alanssitis/smart-air-hockey-table/web/README.md

# Better Website

Just a better site in every way.

All settings are set properly for copy-and-paste into the `/web` directory
of the shay drive. All that needs to be done is to build it.

## Installing `npm`

I use `nvm` to manage node versions. My local machine is running `v18.16.0` as
of Sep 5, 2023.

## Building the site

First, install all dependencies with

```
npm install .
```

Than, build the project with

```
npm run build
```

This will create all the requisites in `/dist`. The contents of `/dist` can
be copied to the shay `/web` directory.
