alanssitis/smart-air-hockey-table/web/src/pages/media.md

---
layout: ../layouts/MDLayout.astro
title: ECE 477 Team 5 Media
---

# Media

## Project Photos

### Master PCB

_Master PCB Rev. B Render_

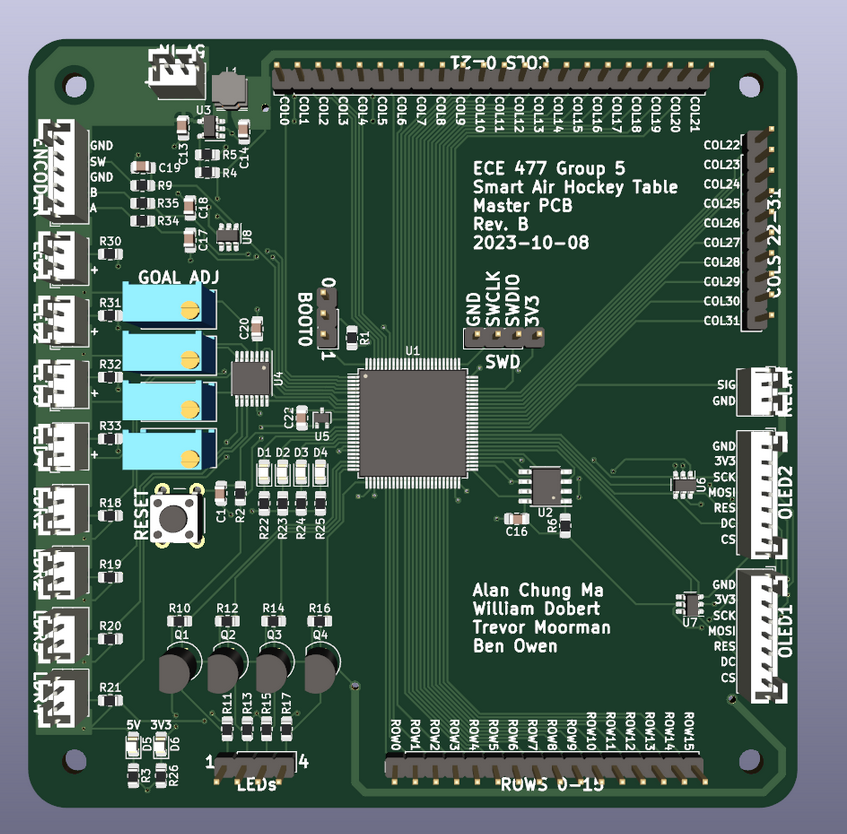
[picture p2: web/public/media/master-pcb-render.png]


_Master PCB Rev. A (assembled)_

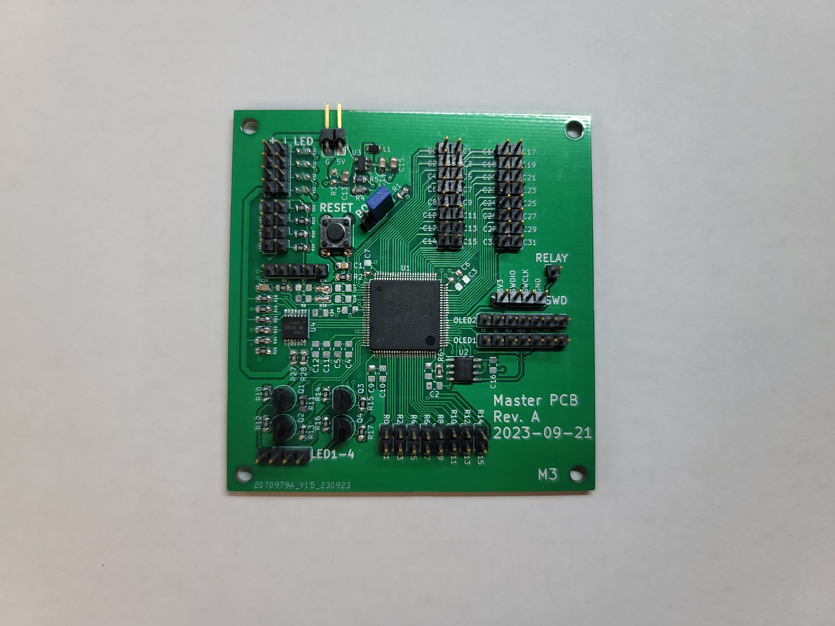
[picture p3: web/public/media/master-pcb-reva.jpg]


### Sensor PCB

_Sensor PCB (assembled)_

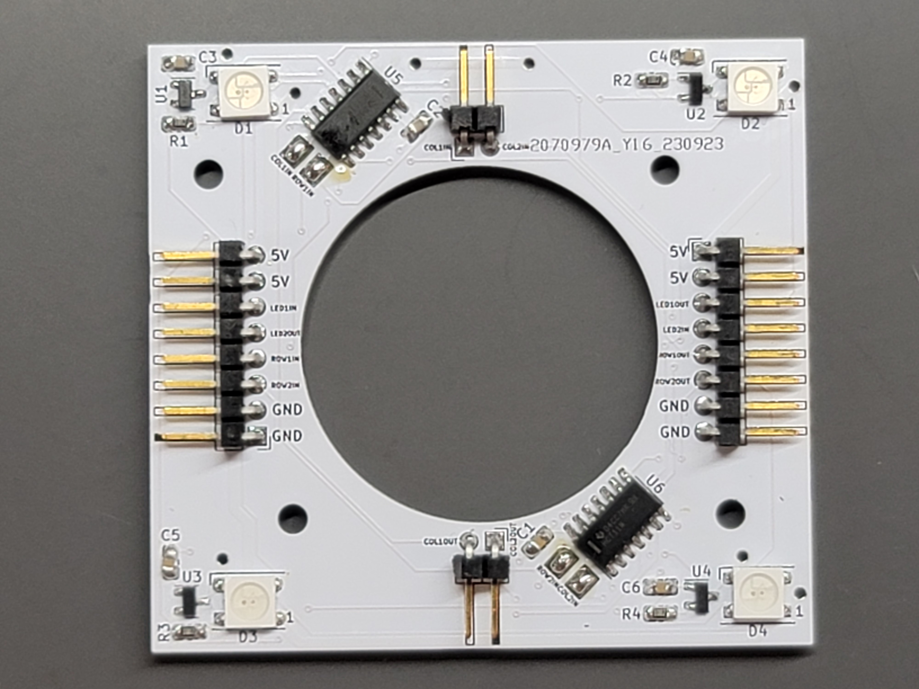
[picture p4: web/public/media/sensor-pcb.jpg]


_Sensor PCB testing_

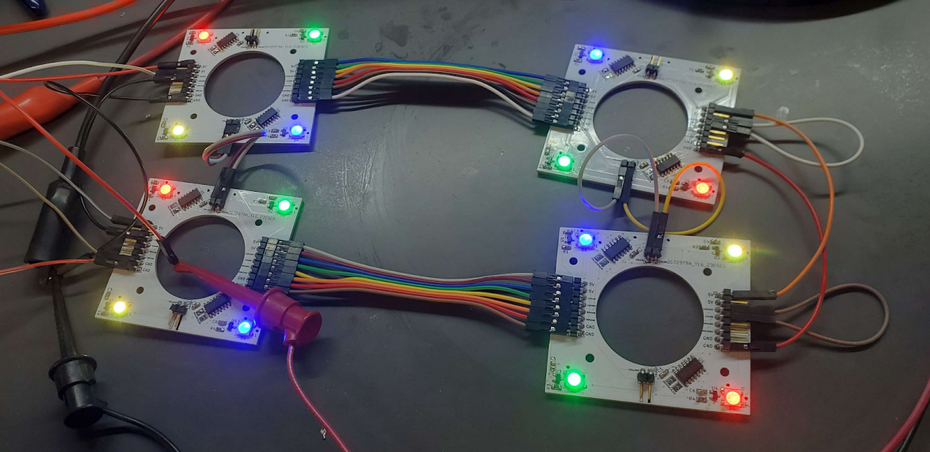
[picture p5: web/public/media/sensor-pcb-lights.png]


## Project Videos

_Sensor PCB testing_

<video controls muted>
  <source src="/team/ben/week6-outlet-relay-test.mp4" type="video/mp4">
</video>
