alanssitis/smart-air-hockey-table/web/public/team/ben/ben-brainstorming-20230901.pdf

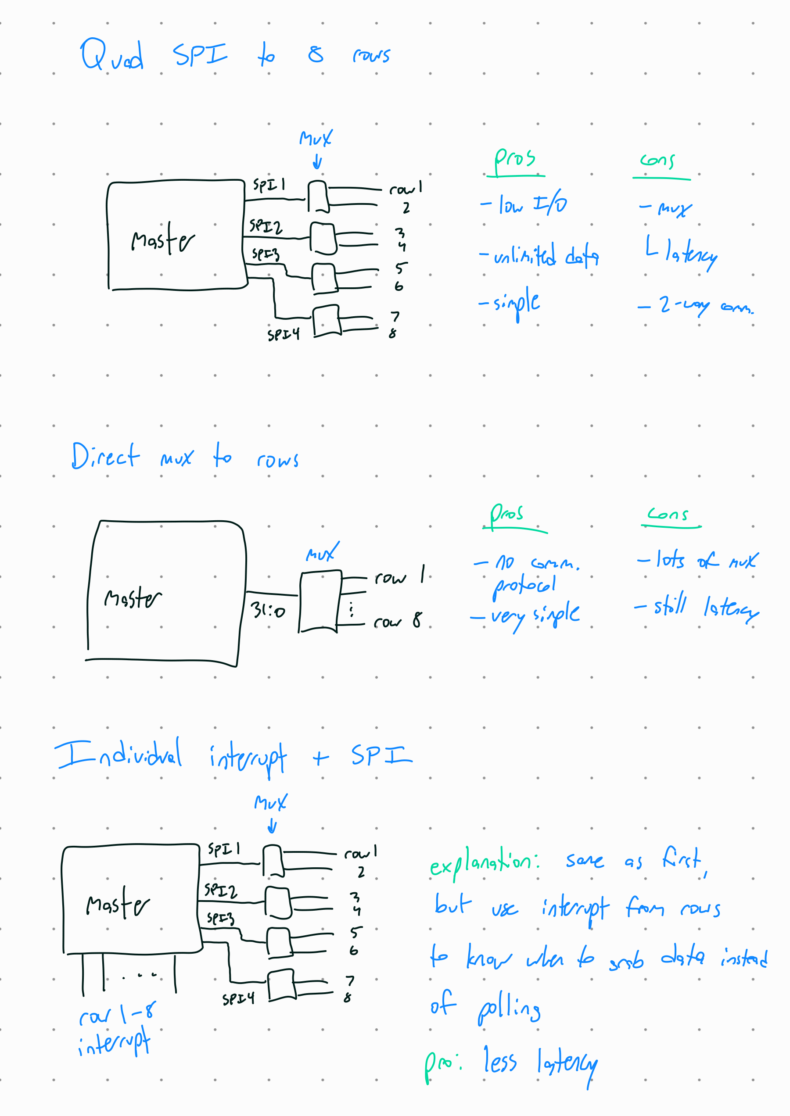
[picture p179: page 1]
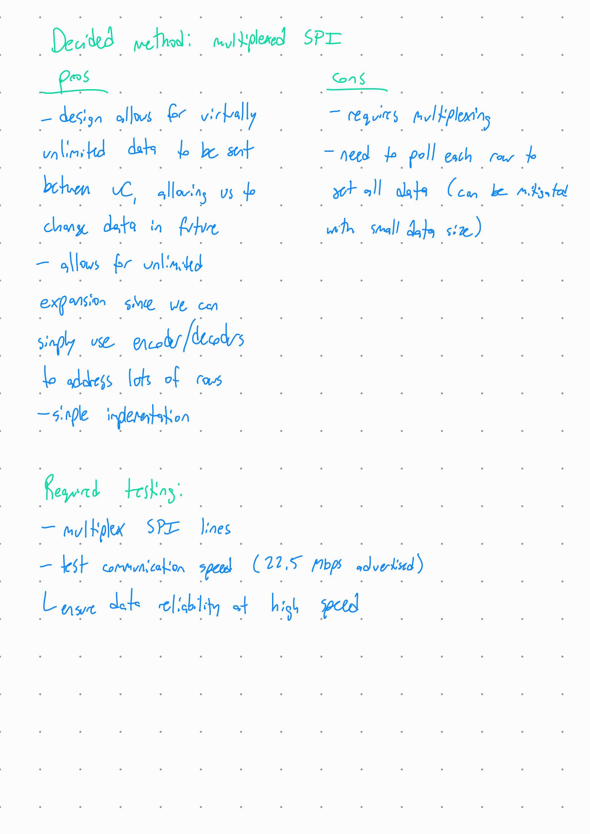
[picture p180: page 2]
