alanssitis/smart-air-hockey-table/web/public/documents/A7 - Bill of Materials.xlsx

ECE477 Bill of Materials v1.0
Year: 2023 |  | Semester: Fall |  |  | Project Name: Smart Air Hockey Table
Authors: Alan Chung Ma, Benjamin Owen, Trevor Moorman, William Dobert
Created: 9/19/2023
Last Modified: 9/23/2023
Main Board |  |  |  |  |  |  |  | Qty: | 1
Description | ID | Qty | Value | Package | Manufacturer | Mfg. Part # | Supplier | Supplier Part #
Microcontroller | STM32U585VIT6 | 1 | - | LQFP100 | STMicroelectronics | STM32U585VIT6 | DigiKey | 497-STM32U585VIT6-ND
OLED Display | SSD1309 | 2 | - | - | Teyleten Robot | SSD1309 | Amazon | ‎B09LND6QJ1
Quad Comparator | LM339 | 1 | - | TSSOP14 | Texas Instruments | LM339PWRG3 | DigiKey | 296-27782-2-ND
Button Rotary Encoder | PEC09-2120F-S0012 | 1 | - | - | Bourns | PEC09-2120F-S0012 | DigiKey | PEC09-2120F-S0012-ND
EEPROM | M95P32-I | 1 | - | SO-8 | STMicroelectronics | M95P32-IXMNT/E | DigiKey | 497-M95P32-IXMNT/ETR-ND
Buck Converter | TLV62568 | 1 | - | - | Texas Instruments | TLV62568DBVR | DigiKey | 296-47359-2-ND
Printed Circuit Board | PCB | 1 | - | - | JLCPCB | - | JLCPCB | -
LED | - | 4 | - | - | - | - | ECE Shop | -
Photoresistor | - | 4 | - | - | - | - | ECE Shop | -
Inductor | DFE21CCN2R2 | 1 | 2.2uH | 0805 | Murata | DFE21CCN2R2MELL | DigiKey | 490-DFE21CCN2R2MELLTR-ND
Resistor | - | 1 | 680K | 0805 | - | - | ECE Shop | -
Resistor | - | 1 | 150K | 0805 | - | - | ECE Shop | -
Pin Headers | 9-146280-0-08 | 12 | - | - | TE Connectivity | 9-146280-0-08 | DigiKey | A32701-08-ND
Daughterboard |  |  |  |  |  |  |  | Qty: | 128
Description | ID | Qty | Value | Package | Manufacturer | Mfg. Part # | Supplier | Supplier Part #
Digital Hall Effect Sensors | DRV5033FA | 4 | - | SOT-23 | Texas Instruments | DRV5033FAQDBZR | DigiKey | 296-44589-2-ND
Triple 3-Way AND Gates | CD74HCT11 | 1 | - | SOIC-14 | Texas Instruments | CD74HCT11M96 | DigiKey | 296-9249-2-ND
RGB LEDs | WS2812B | 4 | - | 5050 | Worldsemi | WS2812B | AliExpress | 3256802466699315
Printed Circuit Board | PCB | 1 | - | - | JLCPCB | - | JLCPCB | -
Pin Headers | 9-103325-0-08 | 3 | - | - | TE Connectivity | 9-103325-0-08 | DigiKey | A32702-08-ND
Dupont Wires | ED-DP_L10_F-F_120pcs | 10 | - | - | EDGELEC | - | Amazon | B07GD312VG
Air Hockey Table |  |  |  |  |  |  |  | Qty: | 1
Description | ID | Qty | Value | Package | Manufacturer | Mfg. Part # | Supplier | Supplier Part #
Centrifugal Blower | 1TDP7 | 1 | 115 Volt, 146 CFM | - | DAYTON | 1TDP7 | Amazon | B00G03XS64
BC Sanded Pine Plywood | - | 1 | 23/32 in. x 4 ft. x 8 ft. | - | Plytanium | 201428 | Home Depot | 166057
MDF Panel | - | 1 | 3/4 in. x 4 ft. x 8 ft. | - | Home Depot | D11612490970000 | Home Depot | 201566
Thick Acrylic Non-Glare, Matte P95 Sheet | - | 1 | 36 in. x 72 in. x 0.125 in. | - | Falken Design | ACRYLIC-P95-1-8/3672 | Home Depot | 1004114887
Wood Panels | - | 8 | - | - | N/A | - | BIDC Back Room | -
AC/DC Transformer Switching Power Supply | YC5V70ATUS | 1 | 5V20A | - | Aclorol | YC5V70ATUS | Amazon | B09J2BFT93
