alanssitis/smart-air-hockey-table/hardware/CAD/Goal_Chute/Goal_Chute.stl

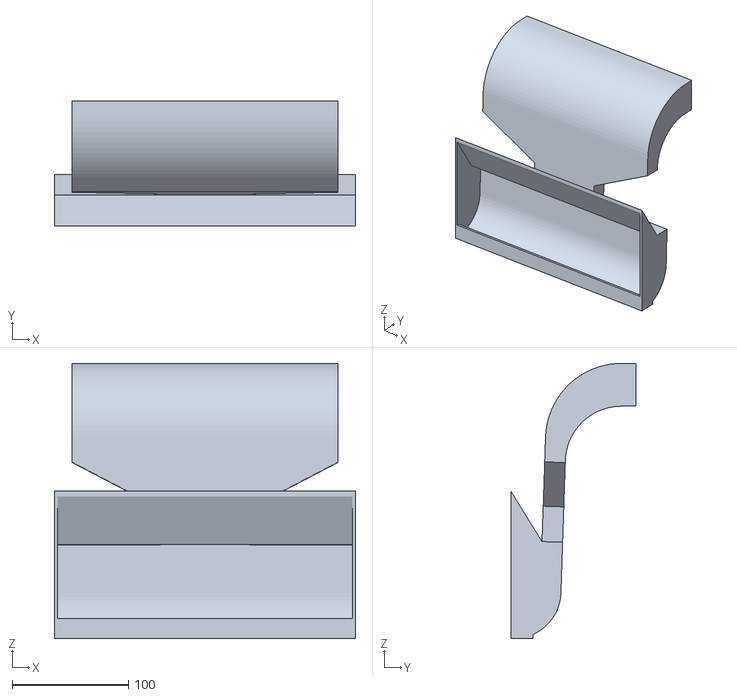
[picture p182: CAD file, 2023-12-10]
hardware/CAD/Goal_Chute/Goal_Chute.stl
259.1 x 107.9 x 236.9
