alanssitis/smart-air-hockey-table/hardware/CAD/Knob/Knob.stl

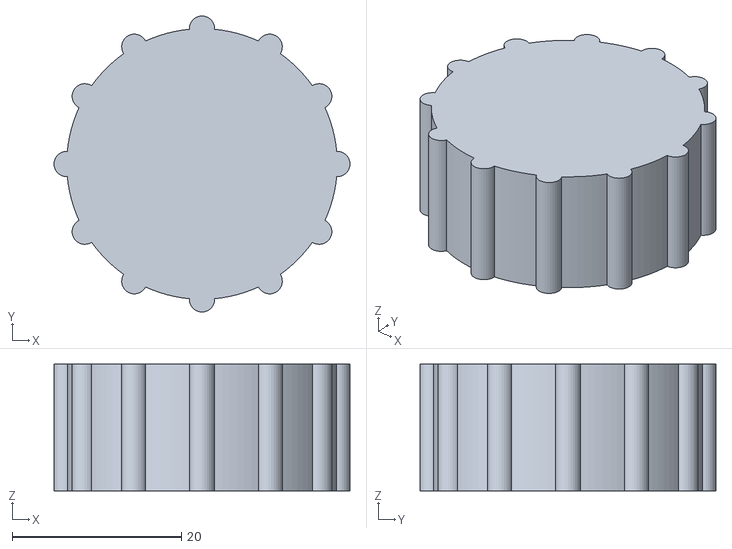
[picture p183: CAD file, 2023-12-10]
hardware/CAD/Knob/Knob.stl
35.0 x 35.0 x 15.0
