alanssitis/smart-air-hockey-table/hardware/CAD/PCB_Mounting/PCB_Mounting.stl

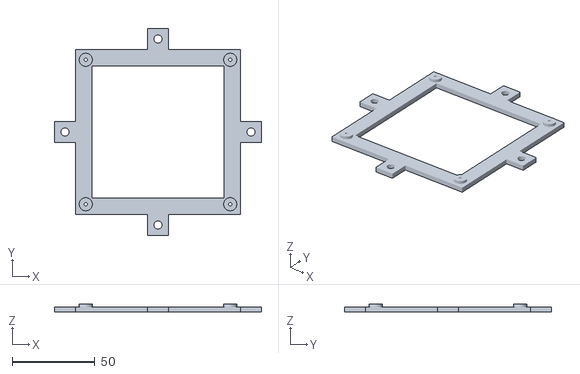
[picture p184: CAD file, 2023-12-10]
hardware/CAD/PCB_Mounting/PCB_Mounting.stl
125.4 x 125.4 x 5.00
