alanssitis/smart-air-hockey-table/hardware/CAD/PSU_Mounting/PSU_Mounting.stl

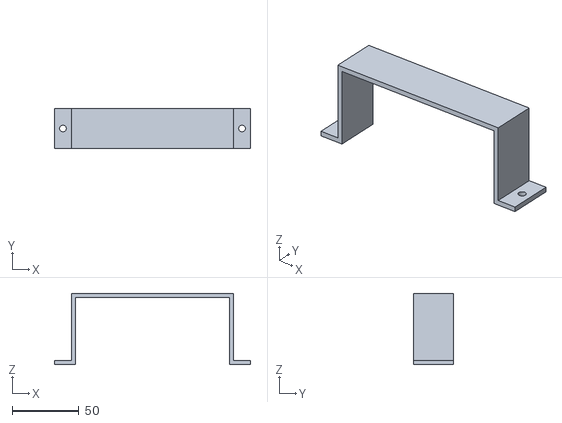
[picture p185: CAD file, 2023-12-10]
hardware/CAD/PSU_Mounting/PSU_Mounting.stl
146.8 x 30.0 x 53.2
