alanssitis/smart-air-hockey-table/hardware/CAD/Puck/Puck-SingleMagnet-Body-Medium.stl

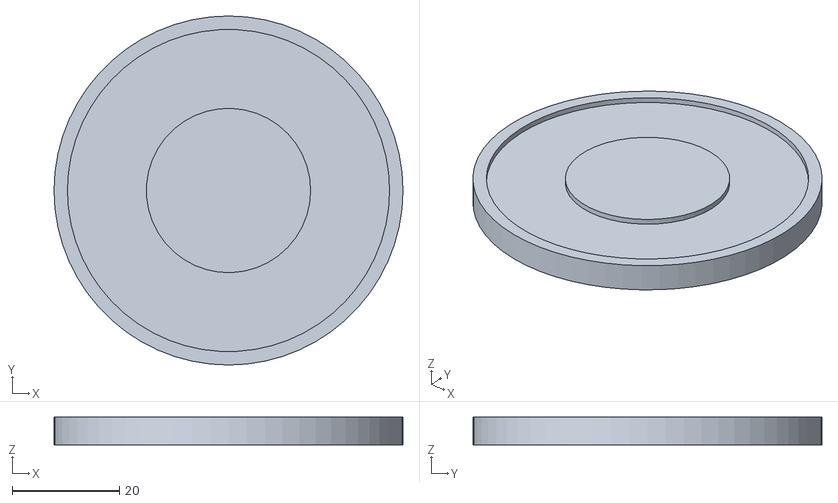
[picture p186: CAD file, 2023-12-10]
hardware/CAD/Puck/Puck-SingleMagnet-Body-Medium.stl
65.0 x 65.0 x 5.20
