alanssitis/smart-air-hockey-table/hardware/CAD/Pusher/Pusher.stl

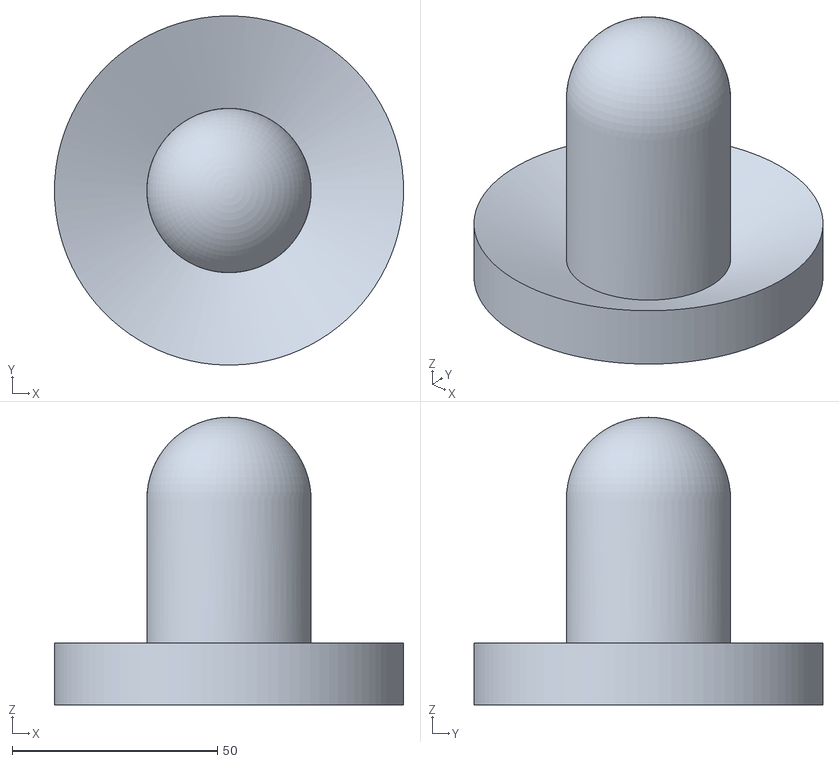
[picture p187: CAD file, 2023-12-10]
hardware/CAD/Pusher/Pusher.stl
85.0 x 85.0 x 70.0
