alanssitis/smart-air-hockey-table/hardware/CAD/Spacers/Spacers-Body.stl

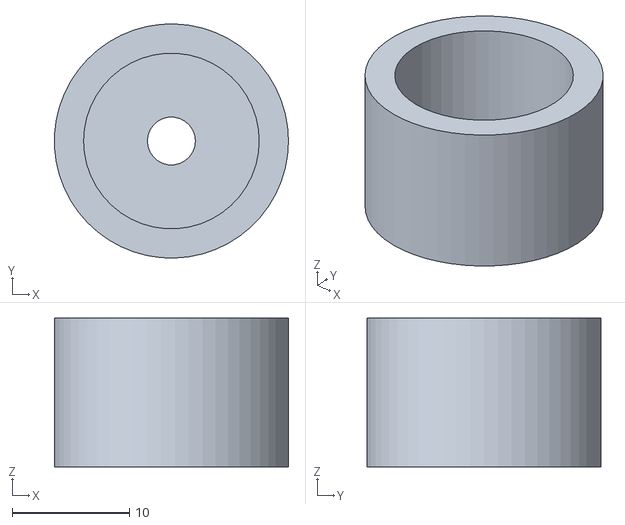
[picture p188: CAD file, 2023-12-02]
hardware/CAD/Spacers/Spacers-Body.stl
20.0 x 20.0 x 12.7
