alanssitis/smart-air-hockey-table/hardware/CAD/Table/Built+to+size.stl

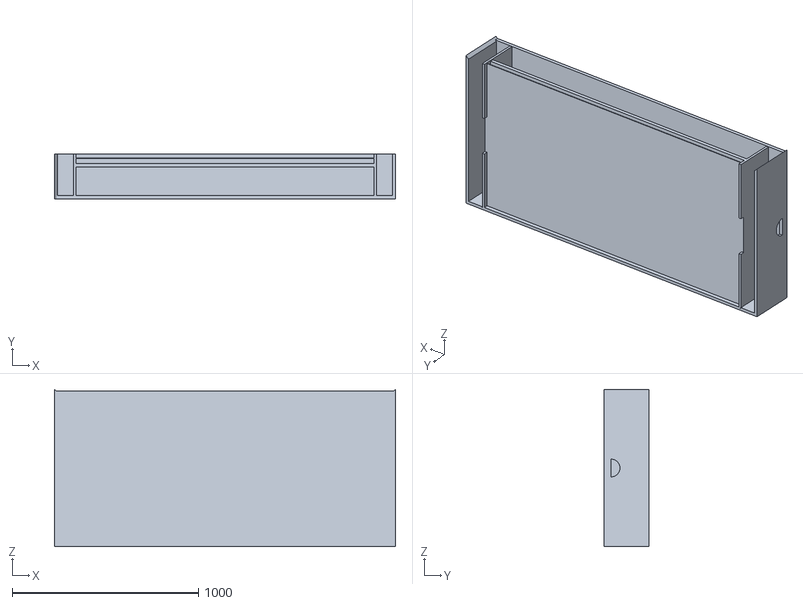
[picture p189: CAD file, 2023-10-10]
hardware/CAD/Table/Built+to+size.stl
1828.8 x 241.3 x 844.5
