alanssitis/smart-air-hockey-table/hardware/CAD/Puck/Puck-SingleMagnet-Body.stl

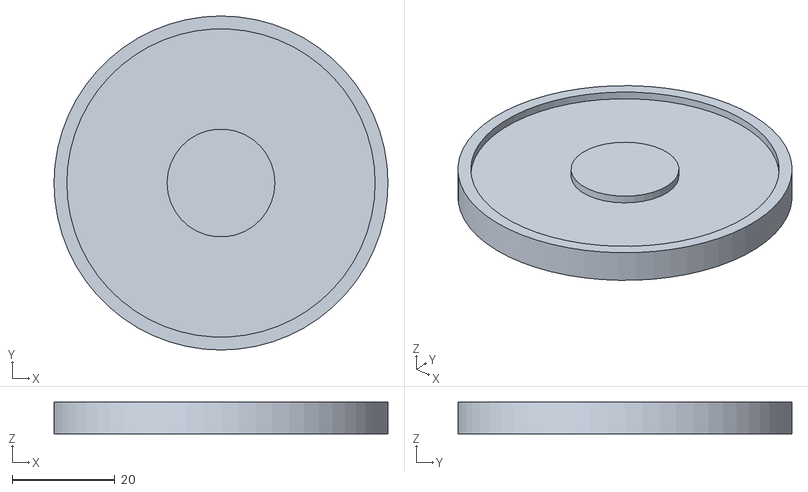
[picture p190: CAD file, 2023-12-03]
hardware/CAD/Puck/Puck-SingleMagnet-Body.stl
65.0 x 65.0 x 6.20
