alanssitis/smart-air-hockey-table/(list of files, cad)

Other CAD files:
hardware/CAD/Puck/Puck-SingleMagnet.FCStd
hardware/CAD/Spacers/Spacers.FCStd
hardware/CAD/Goal_Chute/Goal_Chute.f3d
hardware/CAD/Knob/Knob.f3d
hardware/CAD/PCB_Mounting/PCB_Mounting.f3d
hardware/CAD/PSU_Mounting/PSU_Mounting.f3d
hardware/CAD/Pusher/Pusher.f3d
hardware/CAD/Table/Built+to+size.f3d
