alanssitis/smart-air-hockey-table/(threads)

Thread 46 (2023-09-21):

Driver: OLED Displays

WDobert, 2023-09-21:
### General Specifications (SSD1309)
- 128x64 dot matrix, 1 bit depth
- 3.3V Power and Logic
- 10 MBaud Maximum SPI Interface
- 101.9 Hz default refresh rate

### Pinout
| Pin | Name | Function | Connection |
| --- | --- | --- | --- |
| **1** | *GND* | power ground | All |
| **2** | *VCC* | power positive | All |
| **3** | *SCL* | clock | Shared SPI |
| **4** | *SDA* | data | Shared SPI |
| **5** | *RES* | reset | Shared OLED |
| **6** | *DC* | data/command select | Shared OLED |
| **7** | *CS* | chip select | Individual |

### Functional Specifications
- *SCL* rising edge reads another bit *SDA* MSB first
  - DC determines whether the read byte is data or a command
- *RES* pulled low sets the following:
  - Display off
  - 128x64 display mode
  - `SEG0` and `COM0` mapped to address 0
  - Serial data shift register cleared
  - Display start line set to address 0
  - Column address counter set to 0
  - Normal scan direction of `COM` outputs
  - Contrast control register set to **0x7F**
  - Normal display mode (equal to **0xA4** command)
- Memory Layout is 8 pages-> 128 columns -> 8 bits

See power on sequence on **page 26**.
See frame frequency selection on **page 22**.
See command descriptions on **page 36**.

Closed 2023-10-05.

Thread 86 (2023-10-16):

Driver: Push Button Rotary Encoder

WDobert, 2023-10-16:
- Physical Requirements
  - [Product Page](https://www.digikey.com/en/products/detail/bourns-inc/PEC09-2120F-S0012/2440258)
  - 1 GPIO input pin for push button
  - Hardware timer with support for "Encoder" mode
  - 2 input pins associated with timer
- Firmware Interface
  - `void Driver_Encoder_Tick()`
  - `uint8_t Driver_Encoder_PollButton()`
  - `int8_t Driver_Encoder_PollRotation()`
  - `void Driver_Encoder_SetActive(uint8_t active)`

Closed 2023-10-17.

Thread 93 (2023-10-18):

DMA for Display Driver

WDobert, 2023-10-18:
Currently, we have the CPU feeding individual bytes to SPI to fill regions of the display.
Instead, the CPU will write to a display buffer, and DMA will stream that to SPI to update the entire display.
Basically just make it similar to the LED driver.

Closed 2023-10-18.

Thread 94 (2023-10-18):

Driver: Blower Fan Power Relay

WDobert, 2023-10-18:
- Physical Requirements
  - [Blower Fan](https://www.amazon.com/dp/B00G03XS64)
  - [Power Relay](https://www.amazon.com/dp/B00WV7GMA2)
  - 1 GPIO output pin
- Firmware Interface
  - `void Driver_Fan_SetPowered(uint8_t powered)`

Closed 2023-10-19.

Thread 107 (2023-10-24):

Replace EXTI in `driver_encoder.c` With Software Debouncing

WDobert, 2023-10-24:
Filter in the same manner as `driver_goal.c`.

Closed 2023-10-25.

Thread 110 (2023-10-26):

Remove Most Instances of `volatile` Keyword

WDobert, 2023-10-26:
Only variables modified by interrupts with higher priority than `TIM7_Handler` need to be `volatile`.

`volatile` tells compiler that the value could change at any time, even if the current function doesn't modify it. It means the value is reloaded from RAM basically any time it is read, instead of leaving it cached in a register.

Closed 2023-10-27.

Thread 121 (2023-10-30):

Implement `Driver_LED_GetColor` Function

WDobert, 2023-10-30:
Any advanced visuals, such as "fade", require modifying previously set LED matrix colors instead of blindly overwriting.

Additional matrix state will need to be kept in RAM since reconstructing it from the data buffer would be drastically slower.

Recommend storing this state as an array of structs with 3 `uint8_t` members (r, g, b), and converting the setter/getter functions to pass it instead of `uint32_t`.

Recommend exposing `LED_MATRIX_WIDTH` and `LED_MATRIX_HEIGHT` in `driver_led.h`.

benjamin-owen, 2023-10-30:
Probably unnecessarily reducing performance, we can simply have a 2nd buffer which is added to the first one.  This ensures sequential memory accesses (and less of them).

We could also keep a list of changes to be made.  This reduces processing time and only changes what needs to be changed.

WDobert, 2023-10-30:
Closed in favor of #123

Closed 2023-10-30.

Thread 136 (2023-11-06):

Verify PCB Functionality

WDobert, 2023-11-06:
- [x] Buck Converter
- [x] Microcontroller Communication
- [x] Debug LEDs
- [x] Reset Button
- [x] Rotary Encoder
- [x] LDRs
- [x] OLEDs
- [x] LED Matrix Channels
- [x] Hall Effect Polling
- [x] Blower Fan Relay

benjamin-owen, 2023-11-06:
:nerd_face:

Closed 2023-11-07.
