alanssitis/smart-air-hockey-table/hardware/Master PCB/Master PCB.kicad_pcb

## KiCad design hardware/Master PCB/Master PCB.kicad_pcb (2023-10-10)

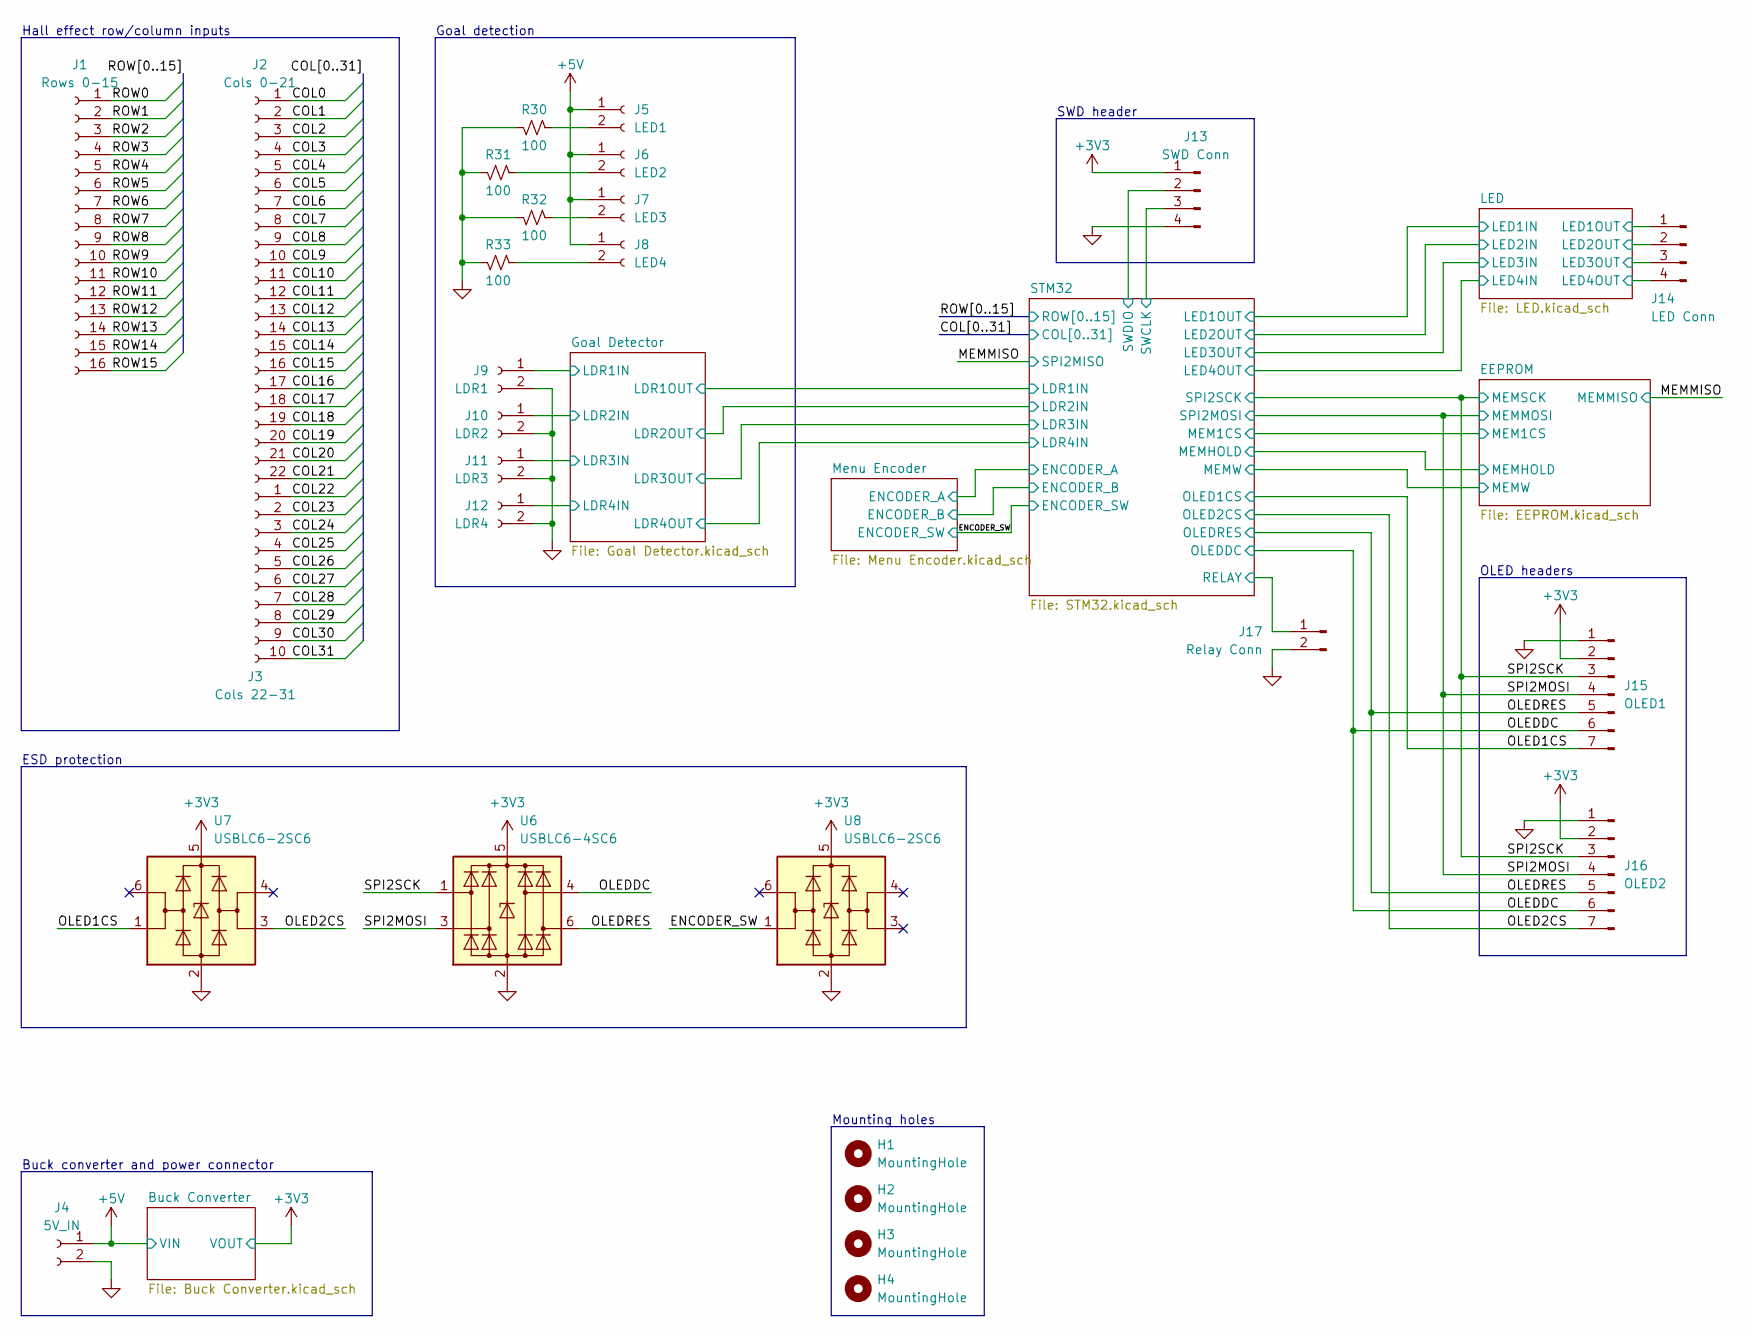
[picture p193: schematic Master PCB.kicad_sch, Smart Air Hockey Table Master PCB]

Parts:
H1, H2, H3, H4: MountingHole; MountingHole_3.2mm_M3
J1: Rows 0-15; PinHeader_1x16_P2.54mm_Vertical
J2: Cols 0-21; PinHeader_1x22_P2.54mm_Vertical
J3: Cols 22-31; PinHeader_1x10_P2.54mm_Vertical
J4: 5V_IN; JST_PH_B2B-PH-K_1x02_P2.00mm_Vertical
J5: LED1; JST_PH_B2B-PH-K_1x02_P2.00mm_Vertical
J6: LED2; JST_PH_B2B-PH-K_1x02_P2.00mm_Vertical
J7: LED3; JST_PH_B2B-PH-K_1x02_P2.00mm_Vertical
J8: LED4; JST_PH_B2B-PH-K_1x02_P2.00mm_Vertical
J9: LDR1; JST_PH_B2B-PH-K_1x02_P2.00mm_Vertical
J10: LDR2; JST_PH_B2B-PH-K_1x02_P2.00mm_Vertical
J11: LDR3; JST_PH_B2B-PH-K_1x02_P2.00mm_Vertical
J12: LDR4; JST_PH_B2B-PH-K_1x02_P2.00mm_Vertical
J13: SWD Conn; PinHeader_1x04_P2.54mm_Vertical
J14: LED Conn; PinHeader_1x04_P2.54mm_Vertical
J15: OLED1; JST_PH_B7B-PH-K_1x07_P2.00mm_Vertical
J16: OLED2; JST_PH_B7B-PH-K_1x07_P2.00mm_Vertical
J17: Relay Conn; JST_PH_B2B-PH-K_1x02_P2.00mm_Vertical
R30, R31, R32, R33: 100; R_0805_2012Metric_Pad1.20x1.40mm_HandSolder
U6: USBLC6-4SC6; SOT-23-6
U7, U8: USBLC6-2SC6; SOT-23-6

Connections:
/COL0: J2.1; also elsewhere on the board
/COL1: J2.2; also elsewhere on the board
/COL2: J2.3; also elsewhere on the board
/COL3: J2.4; also elsewhere on the board
/COL4: J2.5; also elsewhere on the board
/COL5: J2.6; also elsewhere on the board
/COL6: J2.7; also elsewhere on the board
/COL7: J2.8; also elsewhere on the board
/COL8: J2.9; also elsewhere on the board
/COL9: J2.10; also elsewhere on the board
/COL10: J2.11; also elsewhere on the board
/COL11: J2.12; also elsewhere on the board
/COL12: J2.13; also elsewhere on the board
/COL13: J2.14; also elsewhere on the board
/COL14: J2.15; also elsewhere on the board
/COL15: J2.16; also elsewhere on the board
/COL16: J2.17; also elsewhere on the board
/COL17: J2.18; also elsewhere on the board
/COL18: J2.19; also elsewhere on the board
/COL19: J2.20; also elsewhere on the board
/COL20: J2.21; also elsewhere on the board
/COL21: J2.22; also elsewhere on the board
/COL22: J3.1; also elsewhere on the board
/COL23: J3.2; also elsewhere on the board
/COL24: J3.3; also elsewhere on the board
/COL25: J3.4; also elsewhere on the board
/COL26: J3.5; also elsewhere on the board
/COL27: J3.6; also elsewhere on the board
/COL28: J3.7; also elsewhere on the board
/COL29: J3.8; also elsewhere on the board
/COL30: J3.9; also elsewhere on the board
/COL31: J3.10; also elsewhere on the board
/ENCODER_SW: U8.1 (I/O1); also elsewhere on the board
/Goal Detector/LDR1IN: J9.1; also elsewhere on the board
/Goal Detector/LDR2IN: J10.1; also elsewhere on the board
/Goal Detector/LDR3IN: J11.1; also elsewhere on the board
/Goal Detector/LDR4IN: J12.1; also elsewhere on the board
/LED/LED1OUT: J14.1; also elsewhere on the board
/LED/LED2OUT: J14.2; also elsewhere on the board
/LED/LED3OUT: J14.3; also elsewhere on the board
/LED/LED4OUT: J14.4; also elsewhere on the board
/OLED1CS: J15.7, U7.1 (I/O1); also elsewhere on the board
/OLED2CS: J16.7, U7.3 (I/O2); also elsewhere on the board
/OLEDDC: J15.6, J16.6, U6.4 (I/O3); also elsewhere on the board
/OLEDRES: J15.5, J16.5, U6.6 (I/O4); also elsewhere on the board
/ROW0: J1.1; also elsewhere on the board
/ROW1: J1.2; also elsewhere on the board
/ROW2: J1.3; also elsewhere on the board
/ROW3: J1.4; also elsewhere on the board
/ROW4: J1.5; also elsewhere on the board
/ROW5: J1.6; also elsewhere on the board
/ROW6: J1.7; also elsewhere on the board
/ROW7: J1.8; also elsewhere on the board
/ROW8: J1.9; also elsewhere on the board
/ROW9: J1.10; also elsewhere on the board
/ROW10: J1.11; also elsewhere on the board
/ROW11: J1.12; also elsewhere on the board
/ROW12: J1.13; also elsewhere on the board
/ROW13: J1.14; also elsewhere on the board
/ROW14: J1.15; also elsewhere on the board
/ROW15: J1.16; also elsewhere on the board
/SPI2SCK: J15.3, J16.3, U6.1 (I/O1); also elsewhere on the board
/STM32/RELAY: J17.1; also elsewhere on the board
/STM32/SWCLK: J13.3; also elsewhere on the board
/STM32/SWDIO: J13.2; also elsewhere on the board
unnamed: J5.2, R30.1
unnamed: J6.2, R31.1
unnamed: J7.2, R32.1
unnamed: J8.2, R33.1

Notes on the sheet:
Mounting holes
Hall effect row/column inputs
SWD header
ESD protection
OLED headers
Buck converter and power connector
Goal detection

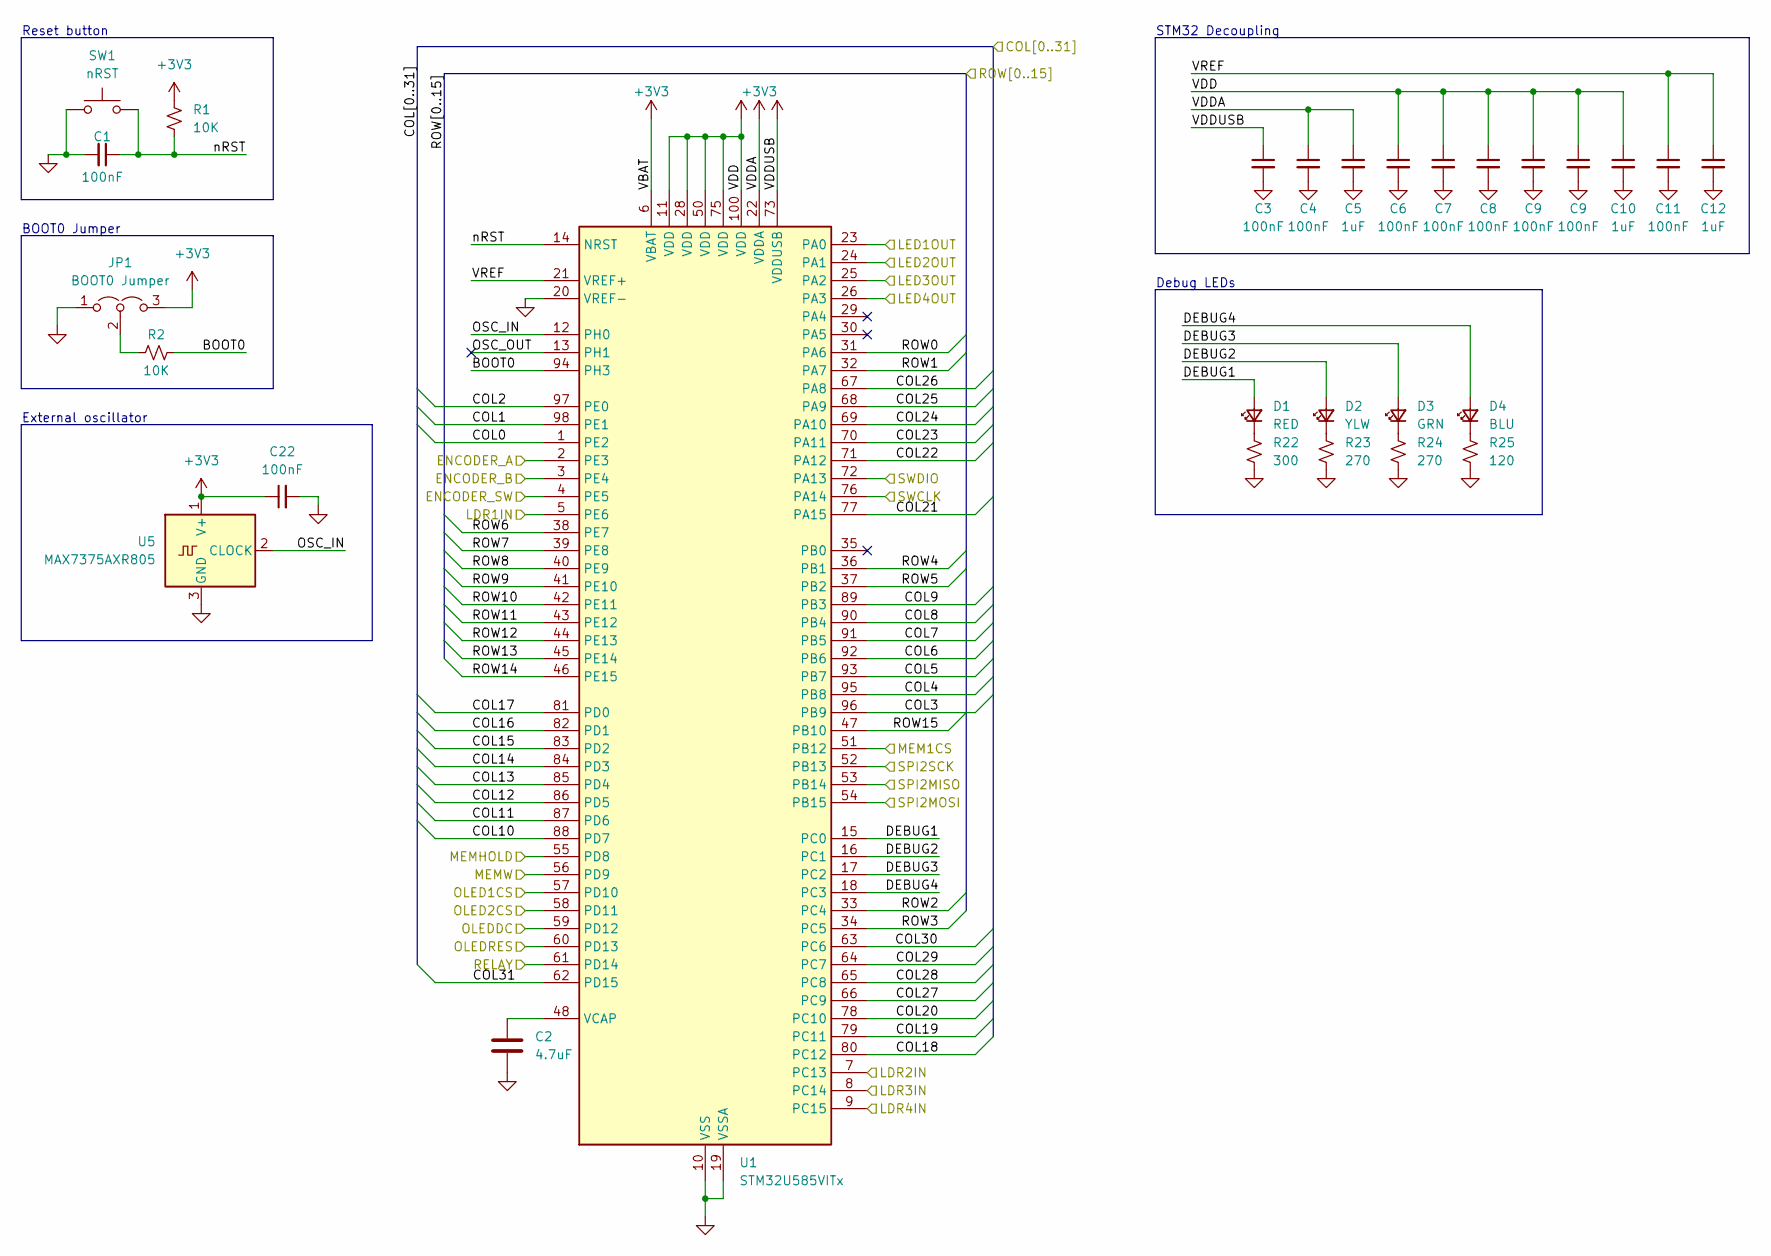
[picture p194: schematic STM32.kicad_sch]

Parts:
C1, C3, C4, C6, C7, C8, C9, C11, C22: 100nF; C_0805_2012Metric_Pad1.18x1.45mm_HandSolder
C2: 4.7uF; C_0805_2012Metric_Pad1.18x1.45mm_HandSolder
C5, C10, C12: 1uF; C_0805_2012Metric_Pad1.18x1.45mm_HandSolder
D1: RED; LED_0805_2012Metric_Pad1.15x1.40mm_HandSolder
D2: YLW; LED_0805_2012Metric_Pad1.15x1.40mm_HandSolder
D3: GRN; LED_0805_2012Metric_Pad1.15x1.40mm_HandSolder
D4: BLU; LED_0805_2012Metric_Pad1.15x1.40mm_HandSolder
JP1: BOOT0 Jumper; PinHeader_1x03_P2.54mm_Vertical
R1, R2: 10K; R_0805_2012Metric_Pad1.20x1.40mm_HandSolder
R22: 300; R_0805_2012Metric_Pad1.20x1.40mm_HandSolder
R23, R24: 270; R_0805_2012Metric_Pad1.20x1.40mm_HandSolder
R25: 120; R_0805_2012Metric_Pad1.20x1.40mm_HandSolder
SW1: nRST; SW_PUSH_6mm
U1: STM32U585VITx; LQFP-100_14x14mm_P0.5mm
U5: MAX7375AXR805; SOT-323_SC-70

Connections:
/COL0: U1.1 (PE2); also elsewhere on the board
/COL1: U1.98 (PE1); also elsewhere on the board
/COL2: U1.97 (PE0); also elsewhere on the board
/COL3: U1.96 (PB9); also elsewhere on the board
/COL4: U1.95 (PB8); also elsewhere on the board
/COL5: U1.93 (PB7); also elsewhere on the board
/COL6: U1.92 (PB6); also elsewhere on the board
/COL7: U1.91 (PB5); also elsewhere on the board
/COL8: U1.90 (PB4); also elsewhere on the board
/COL9: U1.89 (PB3); also elsewhere on the board
/COL10: U1.88 (PD7); also elsewhere on the board
/COL11: U1.87 (PD6); also elsewhere on the board
/COL12: U1.86 (PD5); also elsewhere on the board
/COL13: U1.85 (PD4); also elsewhere on the board
/COL14: U1.84 (PD3); also elsewhere on the board
/COL15: U1.83 (PD2); also elsewhere on the board
/COL16: U1.82 (PD1); also elsewhere on the board
/COL17: U1.81 (PD0); also elsewhere on the board
/COL18: U1.80 (PC12); also elsewhere on the board
/COL19: U1.79 (PC11); also elsewhere on the board
/COL20: U1.78 (PC10); also elsewhere on the board
/COL21: U1.77 (PA15); also elsewhere on the board
/COL22: U1.71 (PA12); also elsewhere on the board
/COL23: U1.70 (PA11); also elsewhere on the board
/COL24: U1.69 (PA10); also elsewhere on the board
/COL25: U1.68 (PA9); also elsewhere on the board
/COL26: U1.67 (PA8); also elsewhere on the board
/COL27: U1.66 (PC9); also elsewhere on the board
/COL28: U1.65 (PC8); also elsewhere on the board
/COL29: U1.64 (PC7); also elsewhere on the board
/COL30: U1.63 (PC6); also elsewhere on the board
/COL31: U1.62 (PD15); also elsewhere on the board
/EEPROM/MEMHOLD: U1.55 (PD8); also elsewhere on the board
/ENCODER_SW: U1.4 (PE5); also elsewhere on the board
/Goal Detector/LDR1OUT: U1.5 (PE6); also elsewhere on the board
/Goal Detector/LDR2OUT: U1.7 (PC13); also elsewhere on the board
/Goal Detector/LDR3OUT: U1.8 (PC14); also elsewhere on the board
/Goal Detector/LDR4OUT: U1.9 (PC15); also elsewhere on the board
/LED/LED1IN: U1.23 (PA0); also elsewhere on the board
/LED/LED2IN: U1.24 (PA1); also elsewhere on the board
/LED/LED3IN: U1.25 (PA2); also elsewhere on the board
/LED/LED4IN: U1.26 (PA3); also elsewhere on the board
/Menu Encoder/ENCODER_A: U1.2 (PE3); also elsewhere on the board
/Menu Encoder/ENCODER_B: U1.3 (PE4); also elsewhere on the board
/OLED1CS: U1.57 (PD10); also elsewhere on the board
/OLED2CS: U1.58 (PD11); also elsewhere on the board
/OLEDDC: U1.59 (PD12); also elsewhere on the board
/OLEDRES: U1.60 (PD13); also elsewhere on the board
/ROW0: U1.31 (PA6); also elsewhere on the board
/ROW1: U1.32 (PA7); also elsewhere on the board
/ROW2: U1.33 (PC4); also elsewhere on the board
/ROW3: U1.34 (PC5); also elsewhere on the board
/ROW4: U1.36 (PB1); also elsewhere on the board
/ROW5: U1.37 (PB2); also elsewhere on the board
/ROW6: U1.38 (PE7); also elsewhere on the board
/ROW7: U1.39 (PE8); also elsewhere on the board
/ROW8: U1.40 (PE9); also elsewhere on the board
/ROW9: U1.41 (PE10); also elsewhere on the board
/ROW10: U1.42 (PE11); also elsewhere on the board
/ROW11: U1.43 (PE12); also elsewhere on the board
/ROW12: U1.44 (PE13); also elsewhere on the board
/ROW13: U1.45 (PE14); also elsewhere on the board
/ROW14: U1.46 (PE15); also elsewhere on the board
/ROW15: U1.47 (PB10); also elsewhere on the board
/SPI2SCK: U1.52 (PB13); also elsewhere on the board
/STM32/DEBUG1: D1.2 (A), U1.15 (PC0)
/STM32/DEBUG2: D2.2 (A), U1.16 (PC1)
/STM32/DEBUG3: D3.2 (A), U1.17 (PC2)
/STM32/DEBUG4: D4.2 (A), U1.18 (PC3)
/STM32/OSC_IN: U1.12 (PH0), U5.2 (CLOCK)
/STM32/OSC_OUT: U1.13 (PH1)
/STM32/RELAY: U1.61 (PD14); also elsewhere on the board
/STM32/SWCLK: U1.76 (PA14); also elsewhere on the board
/STM32/SWDIO: U1.72 (PA13); also elsewhere on the board
/STM32/VREF: C11.1, C12.1, U1.21 (VREF+)
unnamed: D1.1 (K), R22.1
unnamed: D2.1 (K), R23.1
unnamed: D3.1 (K), R24.1
unnamed: D4.1 (K), R25.1
unnamed: C2.1, U1.48 (VCAP)

Notes on the sheet:
Reset button
External oscillator
BOOT0 Jumper
STM32 Decoupling
Debug LEDs

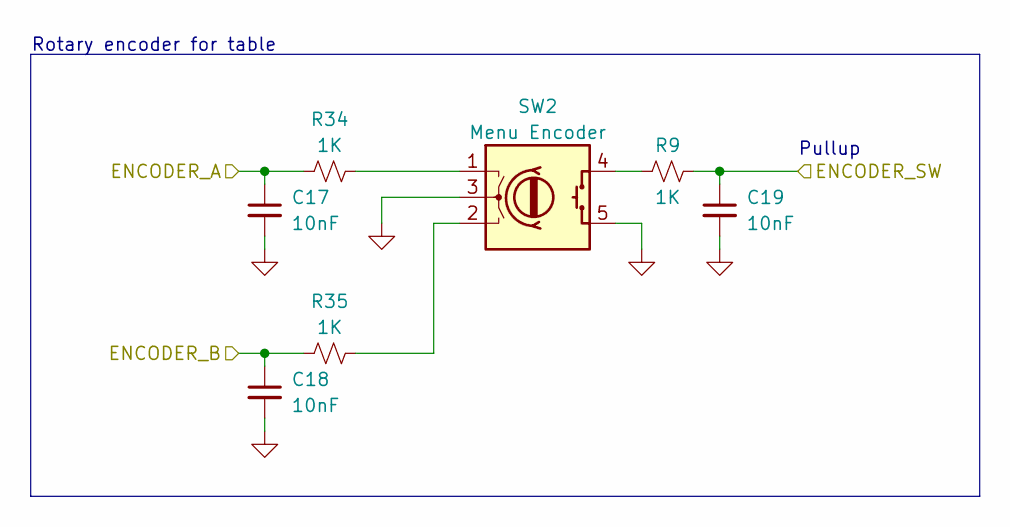
[picture p195: schematic Menu Encoder.kicad_sch]

Parts:
C17, C18, C19: 10nF; C_0805_2012Metric_Pad1.18x1.45mm_HandSolder
R9, R34, R35: 1K; R_0805_2012Metric_Pad1.20x1.40mm_HandSolder
SW2: Menu Encoder; JST_PH_B5B-PH-K_1x05_P2.00mm_Vertical

Connections:
/ENCODER_SW: C19.1, R9.2; also elsewhere on the board
/Menu Encoder/ENCODER_A: C17.1, R34.1; also elsewhere on the board
/Menu Encoder/ENCODER_B: C18.1, R35.1; also elsewhere on the board
unnamed: R34.2, SW2.1 (A)
unnamed: R35.2, SW2.2 (B)
unnamed: R9.1, SW2.4 (S1)

Notes on the sheet:
Rotary encoder for table
Pullup

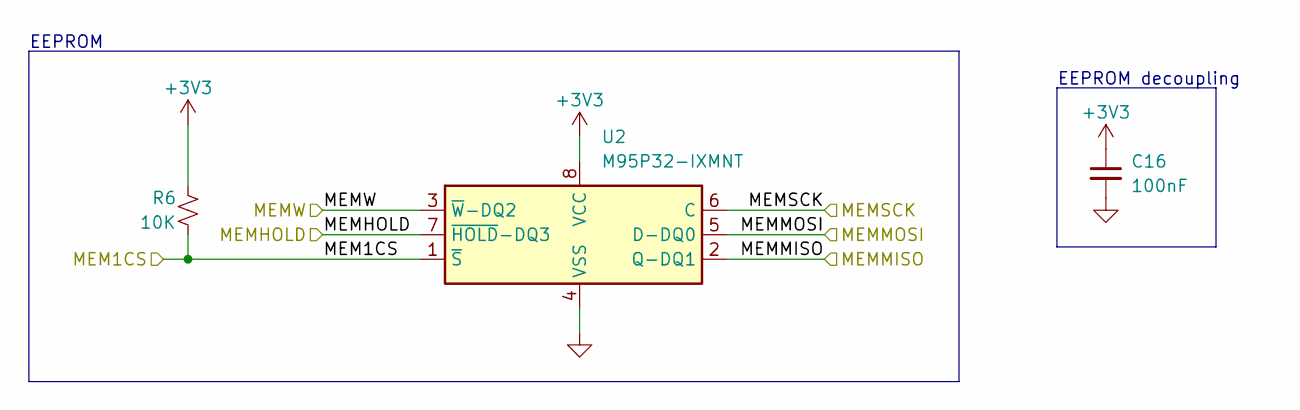
[picture p196: schematic EEPROM.kicad_sch]

Parts:
C16: 100nF; C_0805_2012Metric_Pad1.18x1.45mm_HandSolder
R6: 10K; R_0805_2012Metric_Pad1.20x1.40mm_HandSolder
U2: M95P32-IXMNT; SO-8_3.9x4.9mm_P1.27mm

Connections:
/EEPROM/MEMHOLD: U2.7 (~HOLD-DQ3); also elsewhere on the board
/SPI2SCK: U2.6 (C); also elsewhere on the board

Notes on the sheet:
EEPROM
EEPROM decoupling

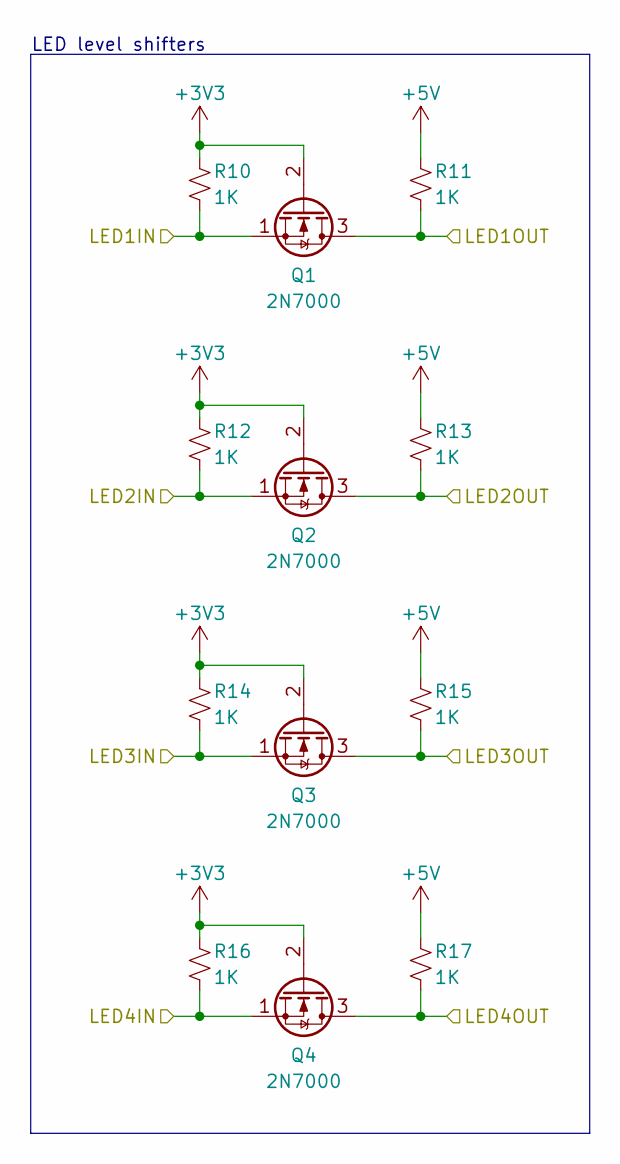
[picture p197: schematic LED.kicad_sch]

Parts:
Q1, Q2, Q3, Q4: 2N7000; TO-92_Inline
R10, R11, R12, R13, R14, R15, R16, R17: 1K; R_0805_2012Metric_Pad1.20x1.40mm_HandSolder

Connections:
/LED/LED1IN: Q1.1 (S), R10.2; also elsewhere on the board
/LED/LED1OUT: Q1.3 (D), R11.2; also elsewhere on the board
/LED/LED2IN: Q2.1 (S), R12.2; also elsewhere on the board
/LED/LED2OUT: Q2.3 (D), R13.2; also elsewhere on the board
/LED/LED3IN: Q3.1 (S), R14.2; also elsewhere on the board
/LED/LED3OUT: Q3.3 (D), R15.2; also elsewhere on the board
/LED/LED4IN: Q4.1 (S), R16.2; also elsewhere on the board
/LED/LED4OUT: Q4.3 (D), R17.2; also elsewhere on the board

Notes on the sheet:
LED level shifters

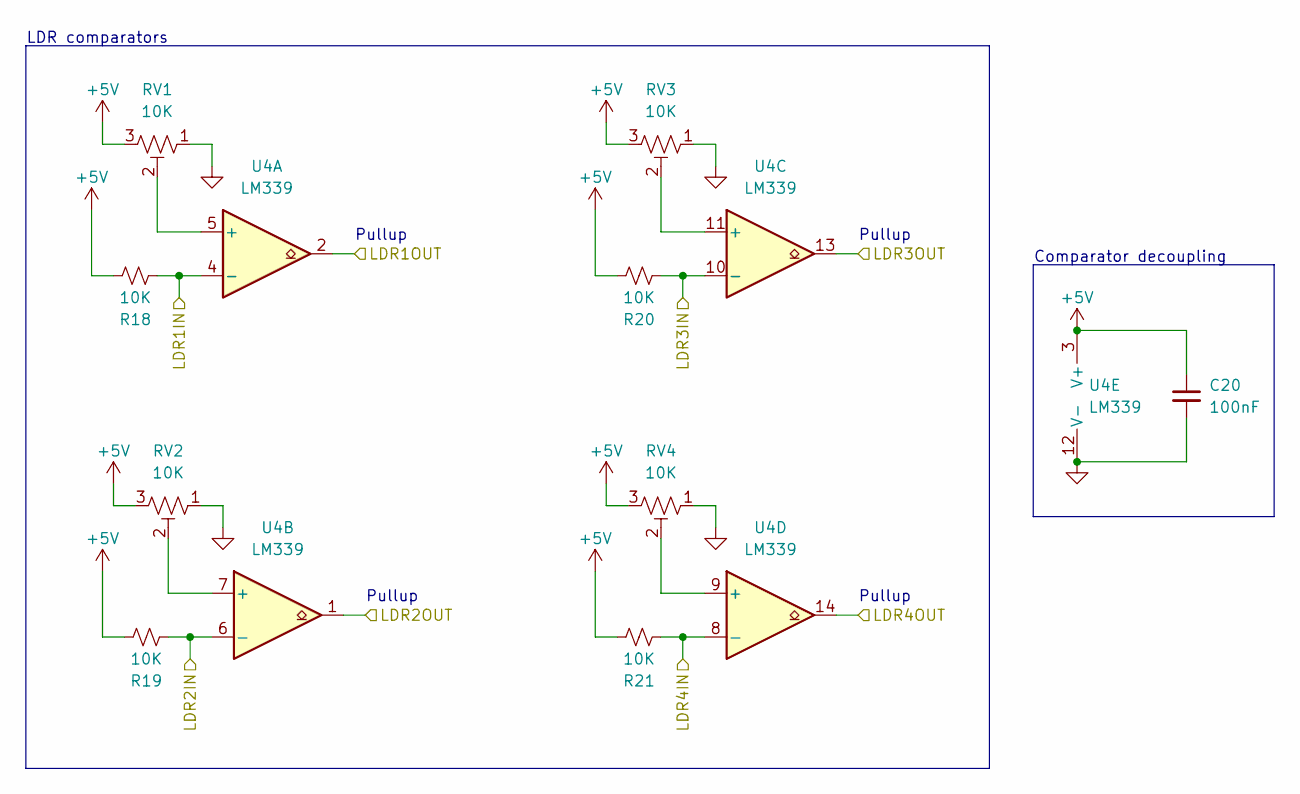
[picture p198: schematic Goal Detector.kicad_sch]

Parts:
C20: 100nF; C_0805_2012Metric_Pad1.18x1.45mm_HandSolder
R18, R19, R20, R21: 10K; R_0805_2012Metric_Pad1.20x1.40mm_HandSolder
RV1, RV2, RV3, RV4: 10K; Potentiometer_Bourns_3296W_Vertical
U4: LM339; TSSOP-14_4.4x5mm_P0.65mm

Connections:
/Goal Detector/LDR1IN: R18.1, U4.4 (-); also elsewhere on the board
/Goal Detector/LDR1OUT: U4.2; also elsewhere on the board
/Goal Detector/LDR2IN: R19.1, U4.6 (-); also elsewhere on the board
/Goal Detector/LDR2OUT: U4.1; also elsewhere on the board
/Goal Detector/LDR3IN: R20.1, U4.10 (-); also elsewhere on the board
/Goal Detector/LDR3OUT: U4.13; also elsewhere on the board
/Goal Detector/LDR4IN: R21.1, U4.8 (-); also elsewhere on the board
/Goal Detector/LDR4OUT: U4.14; also elsewhere on the board
unnamed: RV1.2, U4.5 (+)
unnamed: RV2.2, U4.7 (+)
unnamed: RV3.2, U4.11 (+)
unnamed: RV4.2, U4.9 (+)

Notes on the sheet:
Pullup
LDR comparators
Comparator decoupling

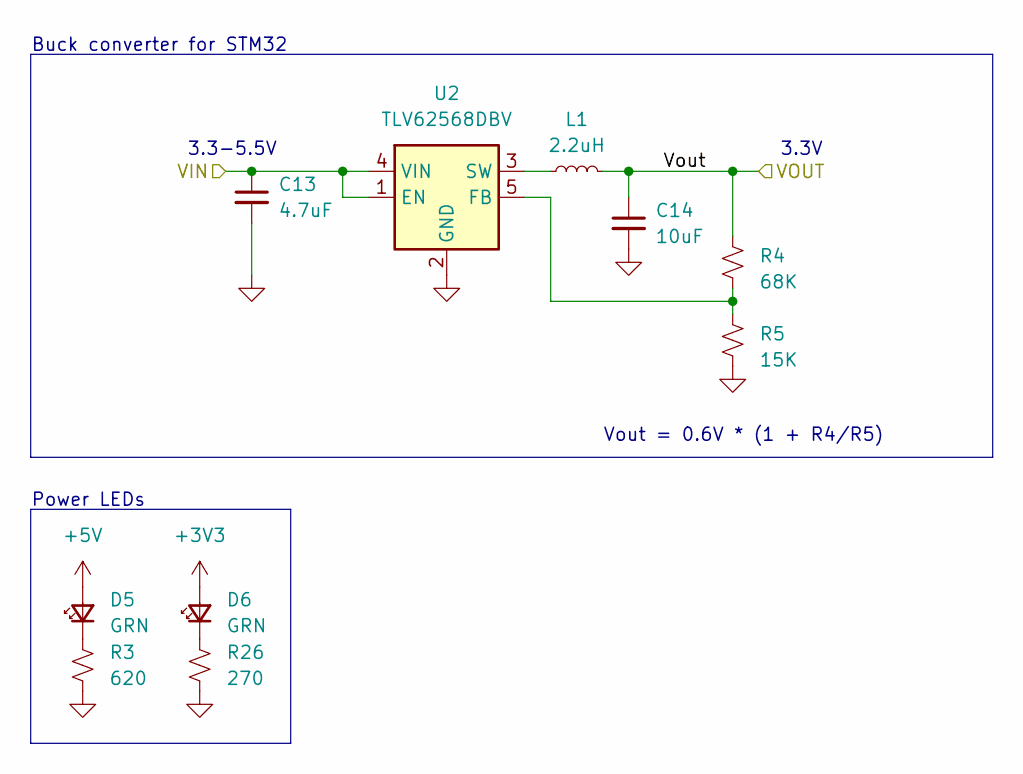
[picture p199: schematic Buck Converter.kicad_sch, STM32 Buck Converter]

Parts:
C13: 4.7uF; C_0805_2012Metric_Pad1.18x1.45mm_HandSolder
C14: 10uF; C_0805_2012Metric_Pad1.18x1.45mm_HandSolder
D5, D6: GRN; LED_0805_2012Metric_Pad1.15x1.40mm_HandSolder
L1: 2.2uH; L_4.0x4.0_H1.8
R3: 620; R_0805_2012Metric_Pad1.20x1.40mm_HandSolder
R4: 68K; R_0805_2012Metric_Pad1.20x1.40mm_HandSolder
R5: 15K; R_0805_2012Metric_Pad1.20x1.40mm_HandSolder
R26: 270; R_0805_2012Metric_Pad1.20x1.40mm_HandSolder
U2: TLV62568DBV; SOT-23-5

Connections:
unnamed: D5.1 (K), R3.1
unnamed: D6.1 (K), R26.1

Notes on the sheet:
Vout = 0.6V * (1 + R4/R5)
3.3V
Power LEDs
Buck converter for STM32
3.3-5.5V

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
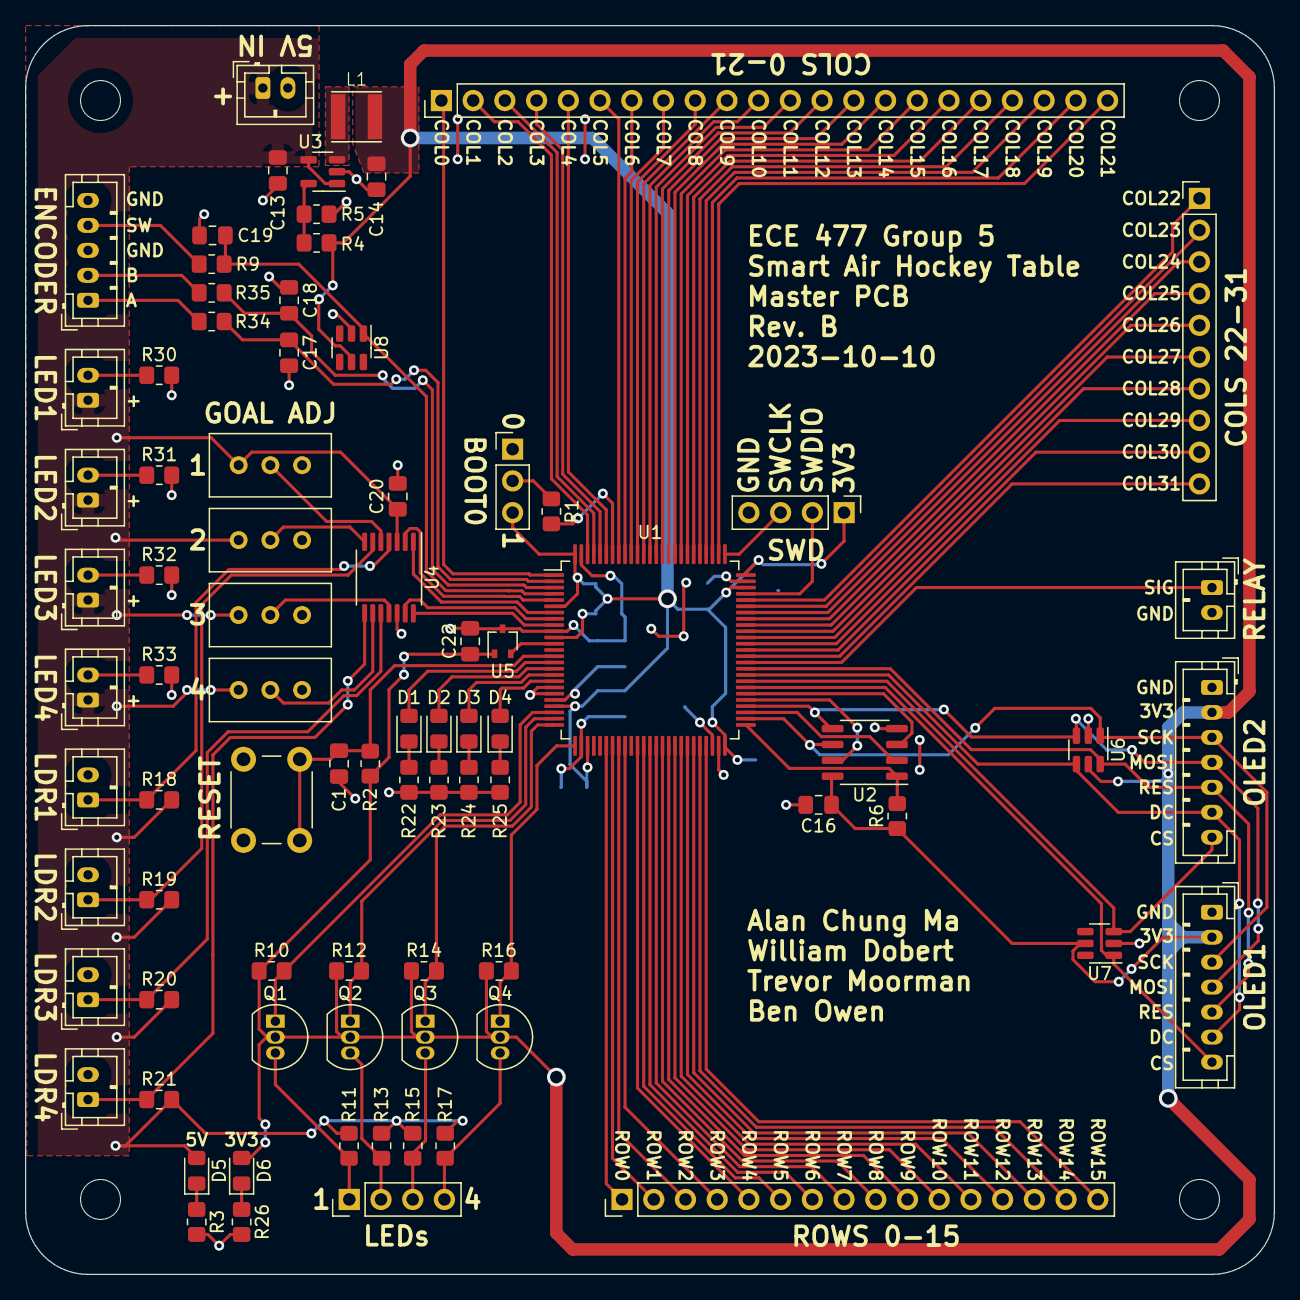
[picture p200: board Master PCB.kicad_pcb from above]

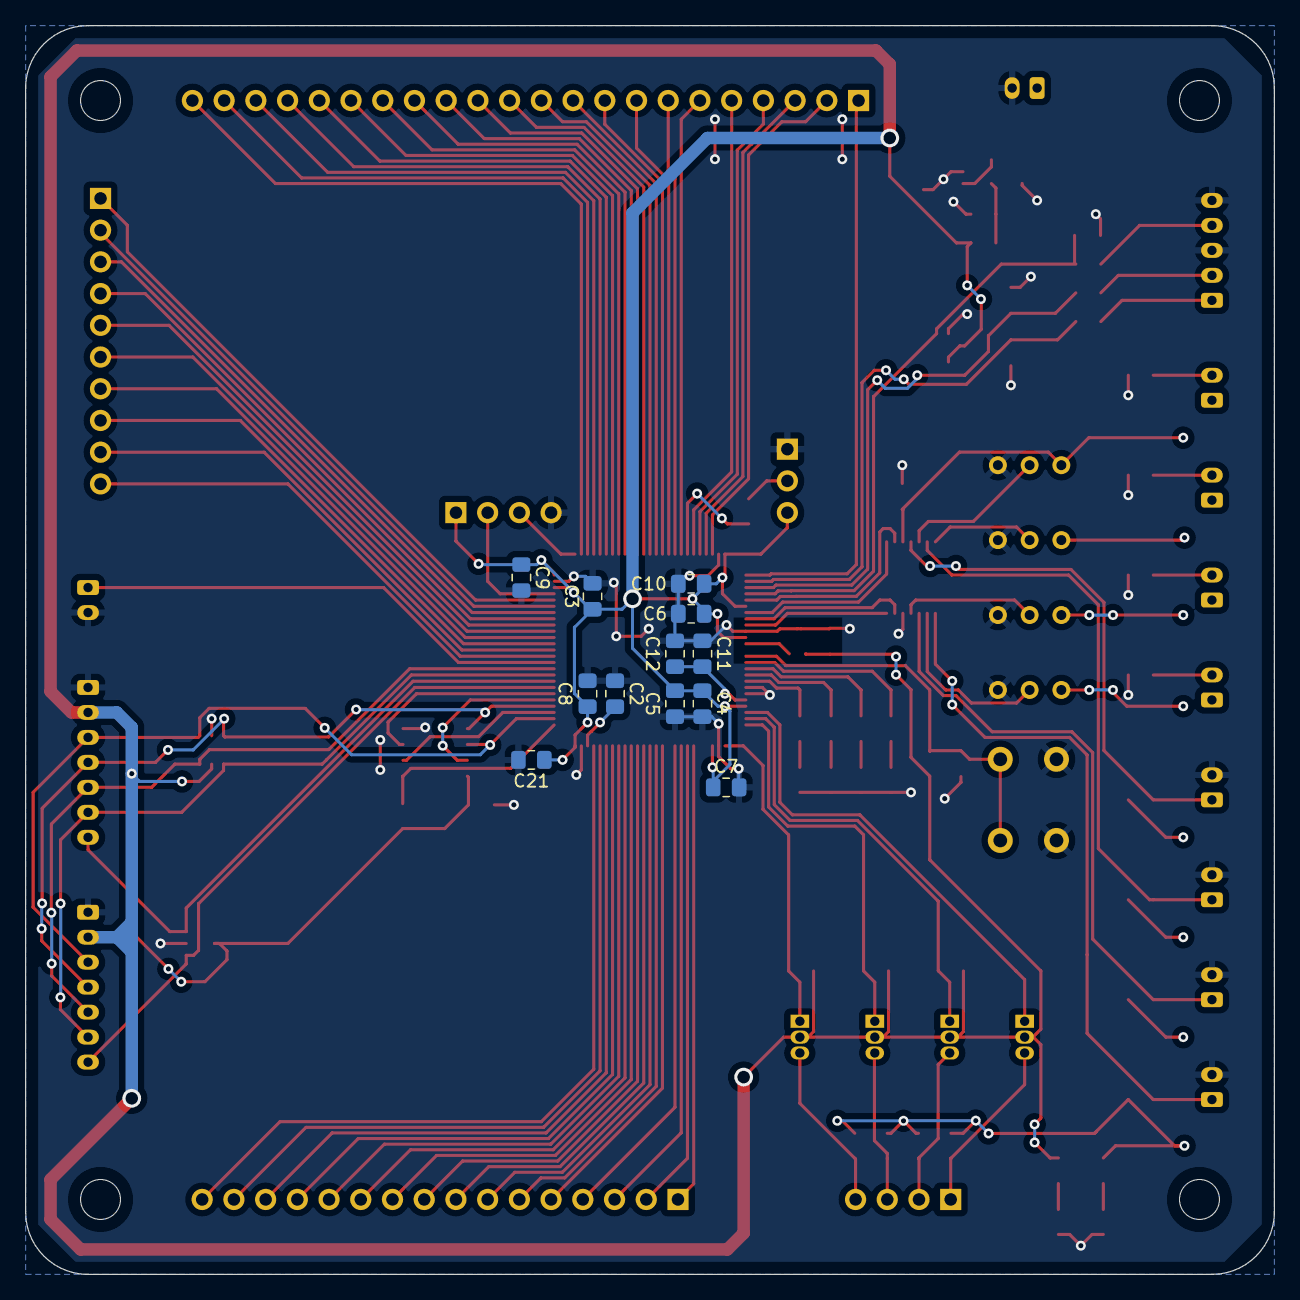
[picture p201: board Master PCB.kicad_pcb from below]

Board: 2 copper layers, 100.0 x 100.0 mm, 98 parts (12 on the bottom side), 112 nets.

Other parts of the board:
C21: 100nF; C_0805_2012Metric_Pad1.18x1.45mm_HandSolder
U3: TLV62568DBV; SOT-23-5
