alanssitis/smart-air-hockey-table/hardware/Sensor PCB/Sensor PCB.kicad_pcb

## KiCad design hardware/Sensor PCB/Sensor PCB.kicad_pcb (2023-10-19)

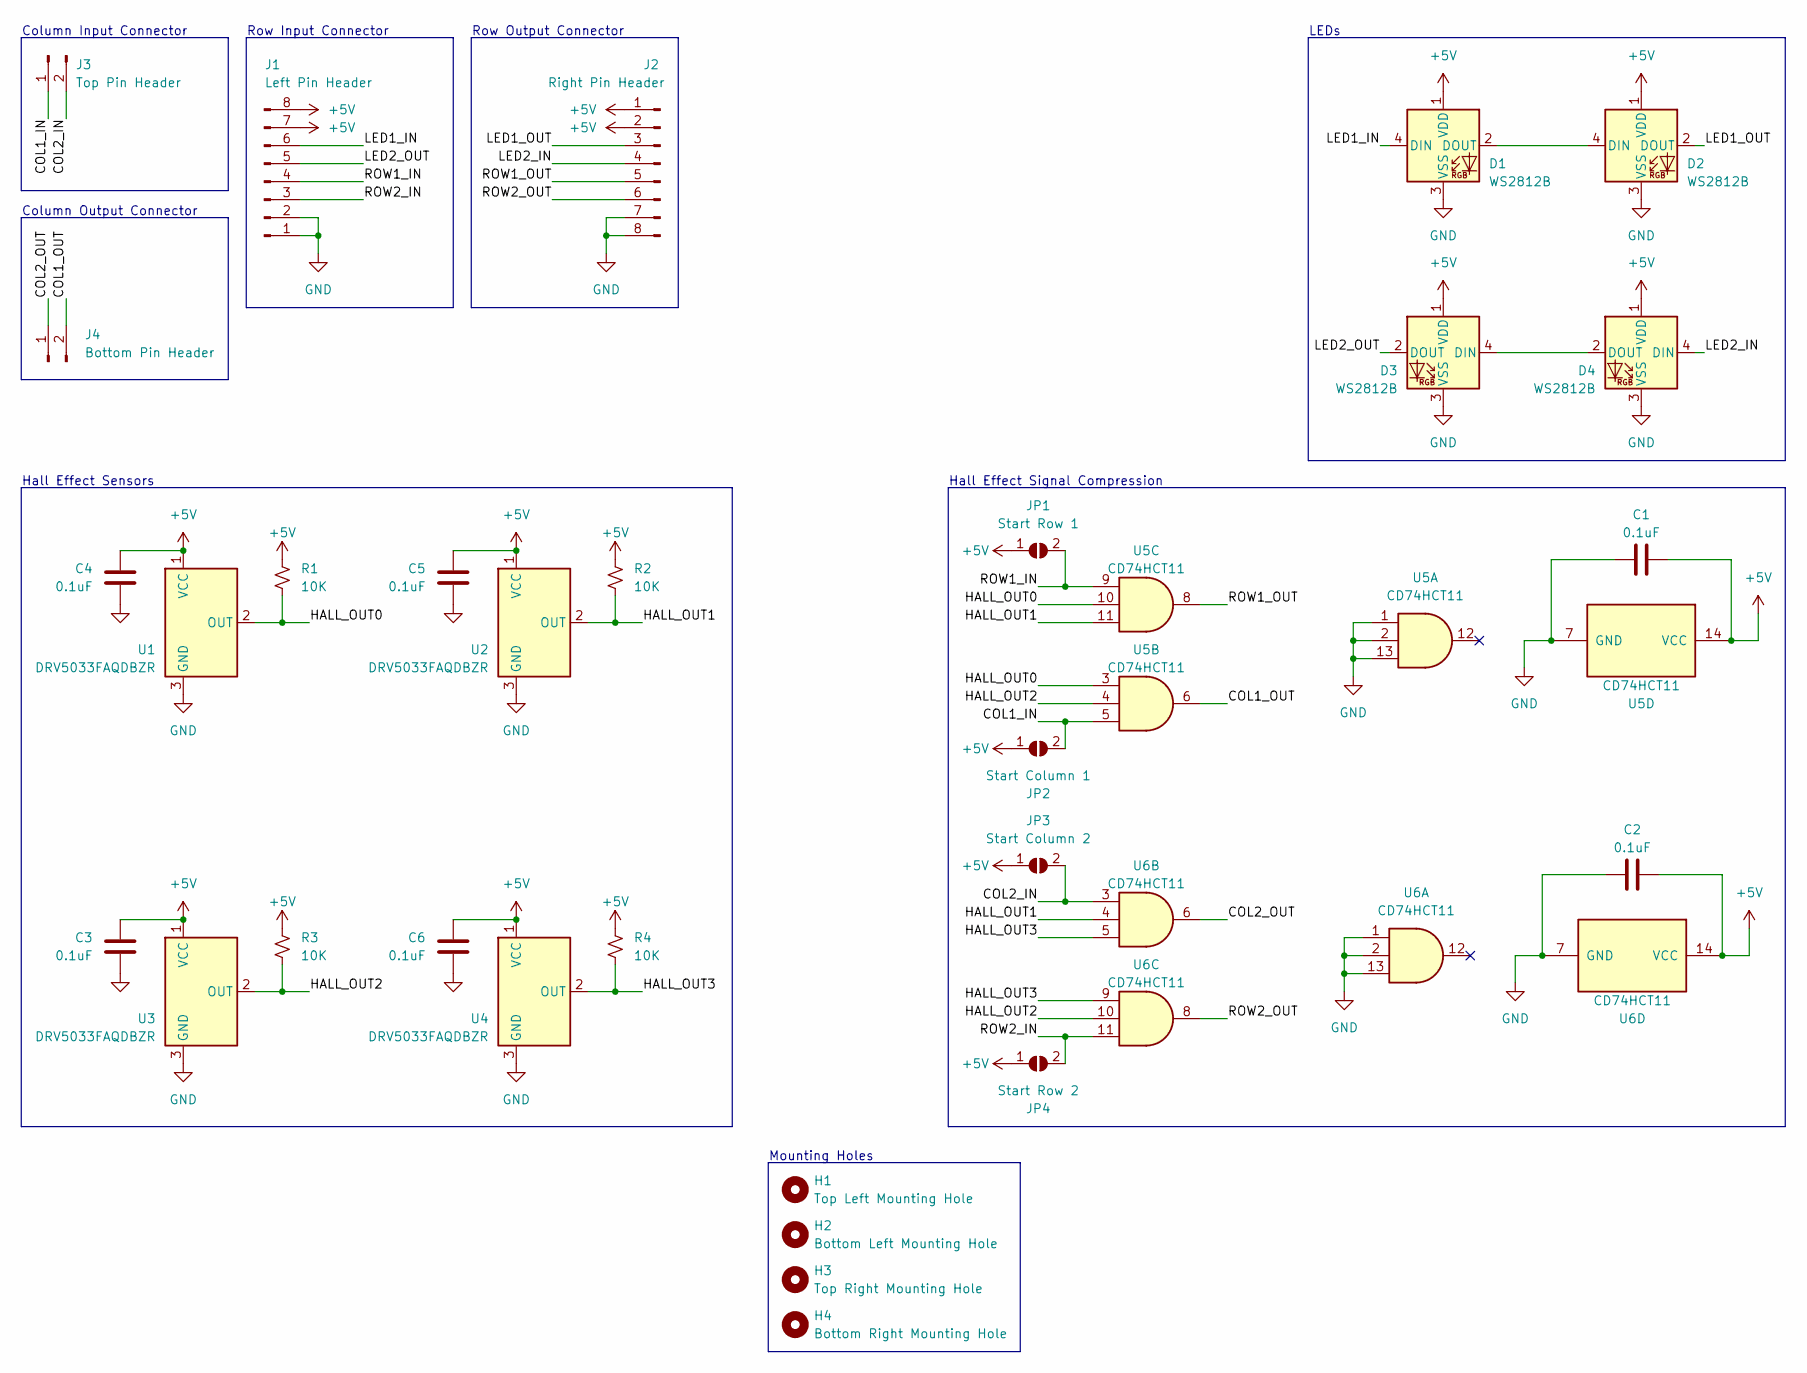
[picture p202: schematic Sensor PCB.kicad_sch]

Parts:
C1, C2, C3, C4, C5, C6: 0.1uF; C_0805_2012Metric_Pad1.18x1.45mm_HandSolder; JLCPCB Part # C49678
D1, D2, D3, D4: WS2812B; LED_WS2812B_PLCC4_5.0x5.0mm_P3.2mm; JLCPCB Part # C4154882
H1: Top Left Mounting Hole; MountingHole_2.7mm_M2.5
H2: Bottom Left Mounting Hole; MountingHole_2.7mm_M2.5
H3: Top Right Mounting Hole; MountingHole_2.7mm_M2.5
H4: Bottom Right Mounting Hole; MountingHole_2.7mm_M2.5
J1: Left Pin Header; PinHeader_1x08_P2.54mm_Horizontal; JLCPCB Part # C492416
J2: Right Pin Header; PinHeader_1x08_P2.54mm_Horizontal; JLCPCB Part # C492416
J3: Top Pin Header; PinHeader_1x02_P2.54mm_Horizontal; JLCPCB Part # C492410
J4: Bottom Pin Header; PinHeader_1x02_P2.54mm_Horizontal; JLCPCB Part # C492410
JP1: Start Row 1; SolderJumper-2_P1.3mm_Open_TrianglePad1.0x1.5mm
JP2: Start Column 1; SolderJumper-2_P1.3mm_Open_TrianglePad1.0x1.5mm
JP3: Start Column 2; SolderJumper-2_P1.3mm_Open_TrianglePad1.0x1.5mm
JP4: Start Row 2; SolderJumper-2_P1.3mm_Open_TrianglePad1.0x1.5mm
R1, R2, R3, R4: 10K; R_0805_2012Metric_Pad1.20x1.40mm_HandSolder; JLCPCB Part # C100047
U1, U2, U3, U4: DRV5033FAQDBZR; SOT-23; JLCPCB Part # C2655029
U5, U6: CD74HCT11; SOIC-14_3.9x8.7mm_P1.27mm; JLCPCB Part # C7643

Connections:
+5V: C1.1, C2.1, C3.1, C4.1, C5.1, C6.1, D1.1 (VDD), D2.1 (VDD), D3.1 (VDD), D4.1 (VDD), J1.7, J1.8, J2.1, J2.2, JP1.1 (A), JP2.1 (A), JP3.1 (A), JP4.1 (A), R1.1, R2.1, R3.1, R4.1, U1.1 (VCC), U2.1 (VCC), U3.1 (VCC), U4.1 (VCC), U5.14 (VCC), U6.14 (VCC)
/COL1_IN: J3.1, JP2.2 (B), U5.5
/COL1_OUT: J4.2, U5.6
/COL2_IN: J3.2, JP3.2 (B), U6.3
/COL2_OUT: J4.1, U6.6
/HALL_OUT0: R1.2, U1.2 (OUT), U5.3, U5.10
/HALL_OUT1: R2.2, U2.2 (OUT), U5.11, U6.4
/HALL_OUT2: R3.2, U3.2 (OUT), U5.4, U6.10
/HALL_OUT3: R4.2, U4.2 (OUT), U6.5, U6.9
/LED1_IN: D1.4 (DIN), J1.6
/LED1_OUT: D2.2 (DOUT), J2.3
/LED2_IN: D4.4 (DIN), J2.4
/LED2_OUT: D3.2 (DOUT), J1.5
/ROW1_IN: J1.4, JP1.2 (B), U5.9
/ROW1_OUT: J2.5, U5.8
/ROW2_IN: J1.3, JP4.2 (B), U6.11
/ROW2_OUT: J2.6, U6.8
GND: C1.2, C2.2, C3.2, C4.2, C5.2, C6.2, D1.3 (VSS), D2.3 (VSS), D3.3 (VSS), D4.3 (VSS), J1.1, J1.2, J2.7, J2.8, U1.3 (GND), U2.3 (GND), U3.3 (GND), U4.3 (GND), U5.1, U5.2, U5.7 (GND), U5.13, U6.1, U6.2, U6.7 (GND), U6.13
unnamed: D1.2 (DOUT), D2.4 (DIN)
unnamed: D3.4 (DIN), D4.2 (DOUT)

Notes on the sheet:
Hall Effect Sensors
Column Input Connector
Row Output Connector
Column Output Connector
Hall Effect Signal Compression
Mounting Holes
LEDs
Row Input Connector
