alanssitis/smart-air-hockey-table/hardware/Sensor PCB/Sensor PCB.kicad_pcb

## KiCad design hardware/Sensor PCB/Sensor PCB.kicad_pcb (continued)

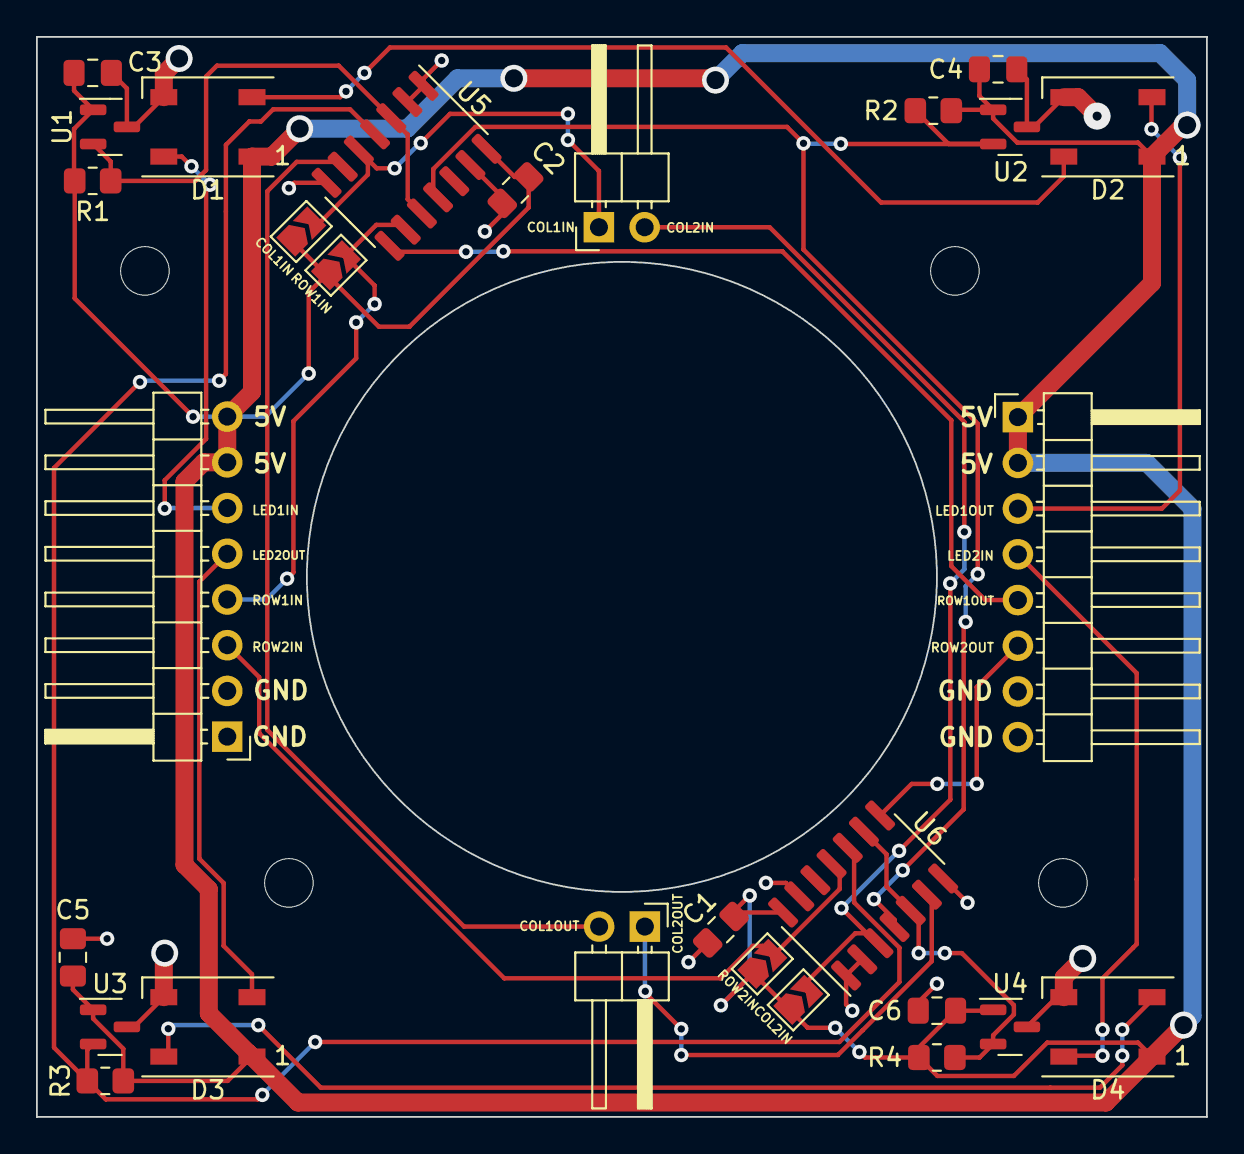
[picture p203: board Sensor PCB.kicad_pcb from above]

Board: 2 copper layers, 65.0 x 60.0 mm, 32 parts (0 on the bottom side), 20 nets.
