alanssitis/smart-air-hockey-table/firmware/smart-air-hockey-table/smart-air-hockey-table.ioc

Mcu.UserName=STM32U575VITx
PA0.GPIO_Label=LED1OUT
PA0.Signal=S_TIM2_CH1
PA1.GPIO_Label=LED2OUT
PA1.Signal=S_TIM2_CH2
PA10.GPIO_Label=COL24
PA10.Signal=GPIO_Input
PA11.GPIO_Label=COL23
PA11.Signal=GPIO_Input
PA12.GPIO_Label=COL22
PA12.Signal=GPIO_Input
PA2.GPIO_Label=LED3OUT
PA2.Signal=S_TIM2_CH3
PA3.GPIO_Label=LED4OUT
PA3.Signal=S_TIM2_CH4
PA6.GPIO_Label=ROW0
PA6.Signal=GPIO_Input
PA7.GPIO_Label=ROW1
PA7.Signal=GPIO_Input
PA8.GPIO_Label=COL26
PA8.Signal=GPIO_Input
PA9.GPIO_Label=COL25
PA9.Signal=GPIO_Input
PB1.GPIO_Label=ROW4
PB1.Signal=GPIO_Input
PB10.GPIO_Label=ROW15
PB10.Signal=GPIO_Input
PB12.GPIO_Label=MEM1CS
PB12.Signal=GPIO_Output
PB13.GPIO_Label=SPI2SCK
PB13.Signal=SPI2_SCK
PB14.GPIO_Label=SPI2MISO
PB14.Signal=SPI2_MISO
PB15.GPIO_Label=SPI2MOSI
PB15.Signal=SPI2_MOSI
PB2.GPIO_Label=ROW5
PB2.Signal=GPIO_Input
PB5.GPIO_Label=COL7
PB5.Signal=GPIO_Input
PB6.GPIO_Label=COL6
PB6.Signal=GPIO_Input
PB7.GPIO_Label=COL5
PB7.Signal=GPIO_Input
PB8.GPIO_Label=COL4
PB8.Signal=GPIO_Input
PB9.GPIO_Label=COL3
PB9.Signal=GPIO_Input
PC0.GPIO_Label=DEBUG1
PC0.Signal=GPIO_Output
PC1.GPIO_Label=DEBUG2
PC1.Signal=GPIO_Output
PC10.GPIO_Label=COL20
PC10.Signal=GPIO_Input
PC11.GPIO_Label=COL19
PC11.Signal=GPIO_Input
PC12.GPIO_Label=COL18
PC12.Signal=GPIO_Input
PC13.GPIO_Label=LDR2IN
PC13.Signal=GPIO_Input
PC2.GPIO_Label=DEBUG3
PC2.Signal=GPIO_Output
PC3.GPIO_Label=DEBUG4
PC3.Signal=GPIO_Output
PC4.GPIO_Label=ROW2
PC4.Signal=GPIO_Input
PC5.GPIO_Label=ROW3
PC5.Signal=GPIO_Input
PC6.GPIO_Label=COL30
PC6.Signal=GPIO_Input
PC7.GPIO_Label=COL29
PC7.Signal=GPIO_Input
PC8.GPIO_Label=COL28
PC8.Signal=GPIO_Input
PC9.GPIO_Label=COL27
PC9.Signal=GPIO_Input
PD0.GPIO_Label=COL17
PD0.Signal=GPIO_Input
PD1.GPIO_Label=COL16
PD1.Signal=GPIO_Input
PD10.GPIO_Label=OLED1CS
PD10.Signal=GPIO_Output
PD11.GPIO_Label=OLED2CS
PD11.Signal=GPIO_Output
PD12.GPIO_Label=OLEDDC
PD12.Signal=GPIO_Output
PD13.GPIO_Label=OLEDRES
PD13.Signal=GPIO_Output
PD14.GPIO_Label=RELAY
PD14.Signal=GPIO_Output
PD15.GPIO_Label=COL31
PD15.Signal=GPIO_Input
PD2.GPIO_Label=COL15
PD2.Signal=GPIO_Input
PD3.GPIO_Label=COL14
PD3.Signal=GPIO_Input
PD4.GPIO_Label=COL13
PD4.Signal=GPIO_Input
PD5.GPIO_Label=COL12
PD5.Signal=GPIO_Input
PD6.GPIO_Label=COL11
PD6.Signal=GPIO_Input
PD7.GPIO_Label=COL10
PD7.Signal=GPIO_Input
PD8.GPIO_Label=MEMHOLD
PD8.Signal=GPIO_Output
PD9.GPIO_Label=MEMW
PD9.Signal=GPIO_Output
PE0.GPIO_Label=COL2
PE0.Signal=GPIO_Input
PE1.GPIO_Label=COL1
PE1.Signal=GPIO_Input
PE10.GPIO_Label=ROW9
PE10.Signal=GPIO_Input
PE11.GPIO_Label=ROW10
PE11.Signal=GPIO_Input
PE12.GPIO_Label=ROW11
PE12.Signal=GPIO_Input
PE13.GPIO_Label=ROW12
PE13.Signal=GPIO_Input
PE14.GPIO_Label=ROW13
PE14.Signal=GPIO_Input
PE15.GPIO_Label=ROW14
PE15.Signal=GPIO_Input
PE2.GPIO_Label=COL0
PE2.Signal=GPIO_Input
PE3.GPIO_Label=ENCODER_A
PE3.Signal=S_TIM3_CH1
PE4.GPIO_Label=ENCODER_B
PE4.Signal=S_TIM3_CH2
PE5.GPIO_Label=ENCODER_SW
PE5.Signal=GPIO_Input
PE6.GPIO_Label=LDR1IN
PE6.Signal=GPIO_Input
PE7.GPIO_Label=ROW6
PE7.Signal=GPIO_Input
PE8.GPIO_Label=ROW7
PE8.Signal=GPIO_Input
PE9.GPIO_Label=ROW8
PE9.Signal=GPIO_Input
