alanssitis/smart-air-hockey-table/firmware-pcb/smart-air-hockey-table/App/Inc/driver_led.h

#ifndef INC_DRIVER_LED_H_
#define INC_DRIVER_LED_H_

#include <inttypes.h>

#define LED_MATRIX_COL_NUM 32
#define LED_MATRIX_ROW_NUM 16
#define LED_MATRIX_PIXEL_COUNT (LED_MATRIX_ROW_NUM * LED_MATRIX_COL_NUM)
#define LED_COLOR_DATA_SIZE 24
#define LED_BRIGHTNESS_LEVELS 13

typedef struct {
	uint8_t red;
	uint8_t green;
	uint8_t blue;
} Color;

void Driver_LED_Init();
void Driver_LED_SetColor(uint_fast8_t col, uint_fast8_t row, Color color);
void Driver_LED_Clear();
void Driver_LED_Tick();
void GPDMA1_Channel0123_Handler(uint_fast8_t channel);

extern uint_fast8_t brightness_idx;

#endif /* INC_DRIVER_LED_H_ */
