alanssitis/smart-air-hockey-table/firmware/smart-air-hockey-table/App/Inc/driver_halleffect.h

#ifndef INC_DRIVER_HALLEFFECT_H_
#define INC_DRIVER_HALLEFFECT_H_

#include <inttypes.h>

extern uint32_t halleffect_cols;
extern uint16_t halleffect_rows;

void Driver_HallEffect_PollInputs();

#endif /* INC_DRIVER_HALLEFFECT_H_ */
