alanssitis/smart-air-hockey-table/firmware/smart-air-hockey-table/App/driver_relay.c

#include "driver_relay.h"

#include "stm32u575xx.h"

#define RELAY_GPIO	GPIOD
#define RELAY_SET	GPIO_BSRR_BS14
#define RELAY_RESET	GPIO_BSRR_BR14

void Driver_Relay_TurnOn()
{
	RELAY_GPIO->BSRR |= RELAY_SET; // turn relay on
}

void Driver_Relay_TurnOff()
{
	RELAY_GPIO->BSRR |= RELAY_RESET; // turn relay off
}
