alanssitis/smart-air-hockey-table/firmware/smart-air-hockey-table/App/Inc/driver_goal.h

#ifndef INC_DRIVER_GOAL_H_
#define INC_DRIVER_GOAL_H_

#include <stdbool.h>

extern bool ldr1_goal;
extern bool ldr2_goal;
extern bool ldr3_goal;
extern bool ldr4_goal;

void Driver_Goal_Poll();

#endif /* INC_DRIVER_GOAL_H_ */
