alanssitis/smart-air-hockey-table/firmware/smart-air-hockey-table/App/Inc/precomputed_highlightpos.h

#ifndef INC_PRECOMPUTED_HIGHLIGHTPOS_H_
#define INC_PRECOMPUTED_HIGHLIGHTPOS_H_

#include <inttypes.h>

#include "app_core.h"
#include "driver_led.h"

uint8_t highlighted_area_size[LED_MATRIX_COL_NUM][LED_MATRIX_ROW_NUM] =
    {
        {
            4,
            6,
            6,
            6,
            6,
            6,
            6,
            6,
            6,
            6,
            6,
            6,
            6,
            6,
            6,
            4,
        },
        {
            6,
            9,
            9,
            9,
            9,
            9,
            9,
            9,
            9,
            9,
            9,
            9,
            9,
            9,
            9,
            6,
        },
        {
            6,
            9,
            9,
            9,
            9,
            9,
            9,
            9,
            9,
            9,
            9,
            9,
            9,
            9,
            9,
            6,
        },
        {
            6,
            9,
            9,
            9,
            9,
            9,
            9,
            9,
            9,
            9,
            9,
            9,
            9,
            9,
            9,
            6,
        },
        {
            6,
            9,
            9,
            9,
            9,
            9,
            9,
            9,
            9,
            9,
            9,
            9,
            9,
            9,
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
            {31, 8},
            {31, 10},
            {30, 8},
            {30, 10},
        },
        {
            {31, 10},
            {30, 10},
            {31, 9},
            {31, 11},
            {30, 9},
            {30, 11},
        },
        {
            {31, 11},
            {30, 11},
            {31, 10},
            {31, 12},
            {30, 10},
            {30, 12},
        },
        {
            {31, 12},
            {30, 12},
            {31, 11},
            {31, 13},
            {30, 11},
            {30, 13},
        },
        {
            {31, 13},
            {30, 13},
            {31, 12},
            {31, 14},
            {30, 12},
            {30, 14},
        },
        {
            {31, 14},
            {30, 14},
            {31, 13},
            {31, 15},
            {30, 13},
            {30, 15},
        },
        {
            {31, 15},
            {30, 15},
            {31, 14},
            {30, 14},
        },
    },
};

#endif /* INC_PRECOMPUTED_HIGHLIGHTPOS_H_ */
