alanssitis/smart-air-hockey-table/firmware/smart-air-hockey-table/App/Inc/precomputed_rainbow.h

#ifndef INC_PRECOMPUTED_RAINBOW_H_
#define INC_PRECOMPUTED_RAINBOW_H_

#include "driver_led.h"

const Color rainbow[] = {
		{ 255, 0, 0 },
		{ 254, 1, 0 },
		{ 253, 2, 0 },
		{ 252, 3, 0 },
		{ 251, 4, 0 },
		{ 250, 5, 0 },
		{ 249, 6, 0 },
		{ 248, 7, 0 },
		{ 247, 8, 0 },
		{ 246, 9, 0 },
		{ 245, 10, 0 },
		{ 244, 11, 0 },
		{ 243, 12, 0 },
		{ 242, 13, 0 },
		{ 241, 14, 0 },
		{ 240, 15, 0 },
		{ 239, 16, 0 },
		{ 238, 17, 0 },
		{ 237, 18, 0 },
		{ 236, 19, 0 },
		{ 235, 20, 0 },
		{ 234, 21, 0 },
		{ 233, 22, 0 },
		{ 232, 23, 0 },
		{ 231, 24, 0 },
		{ 230, 25, 0 },
		{ 229, 26, 0 },
		{ 228, 27, 0 },
		{ 227, 28, 0 },
		{ 226, 29, 0 },
		{ 225, 30, 0 },
		{ 224, 31, 0 },
		{ 223, 32, 0 },
		{ 222, 33, 0 },
		{ 221, 34, 0 },
		{ 220, 35, 0 },
		{ 219, 36, 0 },
		{ 218, 37, 0 },
		{ 217, 38, 0 },
		{ 216, 39, 0 },
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
};

#endif /* INC_PRECOMPUTED_RAINBOW_H_ */
