alanssitis/smart-air-hockey-table/firmware/smart-air-hockey-table/App/Inc/precomputed_color_data_field.h

#ifndef INC_PRECOMPUTED_COLOR_DATA_FIELD_H_
#define INC_PRECOMPUTED_COLOR_DATA_FIELD_H_

#include <inttypes.h>

#include "driver_led.h"

static uint64_t color_data_field[256] = {
		0x0303030303030303,
		0x0603030303030303,
		0x0306030303030303,
		0x0606030303030303,
		0x0303060303030303,
		0x0603060303030303,
		0x0306060303030303,
		0x0606060303030303,
		0x0303030603030303,
		0x0603030603030303,
		0x0306030603030303,
		0x0606030603030303,
		0x0303060603030303,
		0x0603060603030303,
		0x0306060603030303,
		0x0606060603030303,
		0x0303030306030303,
		0x0603030306030303,
		0x0306030306030303,
		0x0606030306030303,
		0x0303060306030303,
		0x0603060306030303,
		0x0306060306030303,
		0x0606060306030303,
		0x0303030606030303,
		0x0603030606030303,
		0x0306030606030303,
		0x0606030606030303,
		0x0303060606030303,
		0x0603060606030303,
		0x0306060606030303,
		0x0606060606030303,
		0x0303030303060303,
		0x0603030303060303,
		0x0306030303060303,
		0x0606030303060303,
		0x0303060303060303,
		0x0603060303060303,
		0x0306060303060303,
		0x0606060303060303,
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
};

#endif /* INC_PRECOMPUTED_COLOR_DATA_FIELD_H_ */
