alanssitis/smart-air-hockey-table/firmware-pcb/smart-air-hockey-table/App/Inc/app_core.h

#ifndef INC_APP_CORE_H_
#define INC_APP_CORE_H_

#include <inttypes.h>
#include <limits.h>

#define BIT_MASK(__TYPE__, __ONE_COUNT__) \
    ((__TYPE__) (-((__ONE_COUNT__) != 0))) \
    & (((__TYPE__) -1) >> ((sizeof(__TYPE__) * CHAR_BIT) - (__ONE_COUNT__)))

typedef struct {
	uint8_t col;
	uint8_t row;
} Coordinate;

void App_Init();
void TIM6_Handler();
void TIM7_Handler();

#endif /* INC_APP_CORE_H_ */
