alanssitis/smart-air-hockey-table/firmware-pcb/smart-air-hockey-table/App/app_core.c

#include "app_core.h"

#include "stm32u5xx_ll_tim.h"
#include "stm32u5xx_ll_utils.h"

#include "app_statemachine.h"
#include "driver_led.h"
#include "driver_display.h"
#include "driver_encoder.h"
#include "driver_goal.h"
#include "driver_relay.h"
#include "driver_halleffect.h"
#include "driver_eeprom.h"

//static volatile uint_fast32_t ticks_elapsed; // volatile: TIM6_Handler has higher priority
//static uint_fast32_t ticks_completed = 0;
//static uint_fast32_t ticks_missed;

void App_Init()
{
	// Configure SysTick to have 1 ms time based on 160 MHz, used by LL_mDelay
	LL_Init1msTick(160000000);

	Driver_LED_Init();
	Driver_Display_Init();
	Driver_Encoder_Init();
	Driver_Eeprom_Init();

	// Last step: set initial state
	App_StateMachine_Init();

//	uint32_t testwrite[2] = {7652, 10287344};
//	Driver_Eeprom_Write_Page(0x8000, rainbow, 574);
//	uint32_t testread[2] = {0, 0};
//	Driver_Eeprom_Read_Data(0x4000, testread, 2);
//	asm("nop");

	// Start 1000 Hz "superloop"
//	LL_TIM_SetUpdateSource(TIM6, LL_TIM_UPDATESOURCE_COUNTER);
	LL_TIM_SetUpdateSource(TIM7, LL_TIM_UPDATESOURCE_COUNTER);
//	LL_TIM_EnableIT_UPDATE(TIM6);
	LL_TIM_EnableIT_UPDATE(TIM7);
//	LL_TIM_EnableCounter(TIM6);
	LL_TIM_EnableCounter(TIM7);

	Driver_LED_Clear();
}

void TIM6_Handler()
{
//	ticks_elapsed++;
}



void TIM7_Handler()
{
//	if (ticks_completed + ticks_missed != ticks_elapsed)
//	{
//		uint_fast32_t ticks_difference = ticks_elapsed - ticks_completed - ticks_missed;
//		ticks_missed += ticks_difference;
//		// Doesn't do much yet, but we can detect when ticks are missed
//	}
	App_StateMachine_GameTick();
}
