alanssitis/smart-air-hockey-table/(commit log)

2023-09-08 Add puck 3D print files
    [Puck-Body.stl, Puck.FCStd]
2023-09-08 updated references page
    added three new references to the team website:
    - uC datasheet
    - uC reference manual
    - RGB LED datasheet
2023-09-08 add hall effect sensor reference
    added datasheet for DRV5053 hall effect sensor
2023-09-08 moved hardware directory to web/public
    moved hw directory to web in order to allow the addition of the files to
    the website
    added symbolic link to the directory
    [Puck-Body.stl, Puck.FCStd]
2023-09-08 updated documents page with Puck body stl
2023-09-09 Change OLED communication protocol from I2C to SPI
2023-09-14 Firmware Project (#36)
    * Code project for STM32F446
    * Move user code 3 block
    * Implement 800 kHz PWM square wave, output on PA6, Timer 3 channel 1
    * Decouple our logic, implement LED strip demo
    * Prepare for DMA
    * Remove TIM3 ISR from app_main.h
    * Nuke .gitignore to allow metadata
    * DMA
    * LED driver base, clean up git
    * Update gitignore
    * Fix some includes
    * Fix interrupt include
    * Clean out .snap files
    * Add .snap to gitignore for now
    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
    [app_core.c, app_core.h, driver_led.c, driver_led.h, main.h, smart-air-hockey-table.ioc]
2023-09-22 Add spacers
2023-09-22 Make schematics larger
2023-09-22 Merge PCB files (#53)
    * Initial commit with some master PCB schematic added
    * Add row/column headers, some hierarchical sheets
    * Add EEPROM
    * Add encoder
    * Add LED level shifters
    * Add goal detection
    * Rearrange schematic
    * Add goal detection pull-up resistors
    * Finish schematic and start routing PCB
    * Route lots
    * Finish routing Master PCB, create sensor PCB project
    * Created schematic and routed all signals besides voltage and ground
    * Route PCB power and change sch/PCB page size to US letter
    * Add production files
    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
    [Buck Converter.kicad_sch, EEPROM.kicad_sch, Goal Detector.kicad_sch, LED.kicad_sch, Master PCB.kicad_pcb, Master PCB.kicad_sch, Menu Encoder.kicad_sch, STM32.kicad_sch]
2023-09-23 add bom
    [A7 - Bill of Materials.xlsx]
2023-09-23 Updated to match submission
    Changes formatting of quantities to be "number" instead of "text" in Microsoft Excel
    [A7 - Bill of Materials.xlsx]
2023-09-28 Grouped Connectors, LEDs, and Mounting Holes
    Each were group separately
    [Sensor PCB.kicad_sch]
2023-09-28 Updated component names
    [Sensor PCB.kicad_sch]
2023-09-29 Connected Hall Effect Sensors to Bus
    [Sensor PCB.kicad_sch]
2023-09-29 Connected AND gates to hall effect output bus
    [Sensor PCB.kicad_sch]
2023-09-29 Bounded AND gate section
    [Sensor PCB.kicad_sch]
2023-09-29 Complete layout without connectors wired
    [Sensor PCB.kicad_sch]
2023-09-29 Wired output connecters
    Connected the outputs of the AND gates to the relevant row and column output connectors
    [Sensor PCB.kicad_sch]
2023-09-29 Wired input connectors
    Connected the outputs of the input connectors to the relevant inputs of the AND gates and LEDs
    [Sensor PCB.kicad_sch]
2023-09-29 Wired LED output to output connector
    [Sensor PCB.kicad_sch]
2023-09-29 Minor changes
    Moved text of some components and minor changes to wiring
    [Sensor PCB.kicad_sch]
2023-09-29 Fixed incorrect wiring and updated PCB with new net names
    [Sensor PCB.kicad_pcb, Sensor PCB.kicad_sch]
2023-09-29 Minor change
    [Sensor PCB.kicad_sch]
2023-09-29 Minor change
    Moved hall effect sensor section up just a little
    [Sensor PCB.kicad_sch]
2023-10-03 Display driver basics
2023-10-03 Change STM32 pinout, begin placing components on new PCB
    [Goal Detector.kicad_sch, Master PCB.kicad_pcb, Master PCB.kicad_sch, STM32.kicad_sch]
2023-10-03 Switch JST to THT
    [Master PCB.kicad_pcb, Master PCB.kicad_sch, STM32.kicad_sch]
2023-10-03 Add ESD ICs and route part of board
    [Goal Detector.kicad_sch, Master PCB.kicad_pcb, Master PCB.kicad_sch, Menu Encoder.kicad_sch, STM32.kicad_sch]
2023-10-03 Added silkscreen text to back of PCB
    [Sensor PCB.kicad_pcb]
2023-10-04 Implement display printing and score tracking
2023-10-04 Finish routing
    [Goal Detector.kicad_sch, Master PCB.kicad_pcb, Master PCB.kicad_sch]
2023-10-04 Add labels, replace inductor, update routing
    [Buck Converter.kicad_sch, Master PCB.kicad_pcb]
2023-10-04 Update labels
    [Master PCB.kicad_pcb, Master PCB.kicad_sch]
2023-10-04 Fix vias
    [Master PCB.kicad_pcb]
2023-10-04 Update buck converter resistor values
    [Buck Converter.kicad_sch]
2023-10-04 Align names
    [Master PCB.kicad_pcb]
2023-10-04 Fix encoder resistor values
    [Menu Encoder.kicad_sch]
2023-10-04 Zone exclusions and resistor value changes
    [Goal Detector.kicad_sch, Master PCB.kicad_pcb]
2023-10-04 Add production files
    [Master PCB.kicad_pcb]
2023-10-04 Updated based on Ben's feedback
    Removed wires between blocks, instead relying on them being connected based on net names (pained me to do this)
    Fixed D3/D4 so they match the PCB layout
    Renamed minor components that were previously unnamed
    [Sensor PCB.kicad_pcb, Sensor PCB.kicad_sch]
2023-10-05 Remove Sensor PCB .lck file
2023-10-05 Move power indicator LEDs to buck converter schematic
    [Buck Converter.kicad_sch, Master PCB.kicad_sch]
2023-10-05 Miscellaneous cleanup
    [Menu Encoder.kicad_sch]
2023-10-05 Update indicator LED resistor values
    [Buck Converter.kicad_sch, STM32.kicad_sch]
2023-10-05 Schematic cleanup
    [Master PCB.kicad_pcb, Master PCB.kicad_sch]
2023-10-05 Fix Init and make ShowScore more general-purpose
    [driver_display.c]
2023-10-05 Shorten power plane along left side of board
    [Master PCB.kicad_pcb]
2023-10-05 Stitch ground plane under STM32
    [Master PCB.kicad_pcb]
2023-10-05 Miscellaneous trace cleanup
    [Master PCB.kicad_pcb]
2023-10-05 Rename nets for clarity
    [Master PCB.kicad_sch, STM32.kicad_sch]
2023-10-05 Change date and generate production files
    [Sensor PCB.kicad_pcb]
2023-10-05 PCB IOC and main.c basics
2023-10-06 Add peripherals to Nucleo project, remove unneeded printf stuff
2023-10-09 Fix encoder schematic and miscellaneous cleanup (new date, etc.)
    [Master PCB.kicad_pcb, Master PCB.kicad_sch, Menu Encoder.kicad_sch, STM32.kicad_sch]
2023-10-09 More misc. cleanup and generate updated production files
    [EEPROM.kicad_sch, Goal Detector.kicad_sch, LED.kicad_sch, Master PCB.kicad_pcb, Menu Encoder.kicad_sch]
2023-10-09 refactor of oled display driver
    moved separator character in score to its own value
    made program print space for unprintable characters
2023-10-09 refactor led write_buffer
2023-10-10 Fix bad trace routing on EEPROM
    [Master PCB.kicad_pcb]
2023-10-10 Add master/sensor PCB files
2023-10-10 Add encoder and OLED controller datasheets
2023-10-10 add updated table cad files
    added air hockey table cad and f3d files
    [Built+to+size.f3d, Built+to+size.stl]
2023-10-10 Update Master PCB files (again)
2023-10-12 LED Driver DMA should work, but it doesn't
    [app_core.c, app_core.h, driver_display.c, driver_display.h, driver_led.c, driver_led.h, main.h]
2023-10-12 Untested display driver revision, should work
2023-10-13 Circular works with HAL, doesn't work with LED driver yet
    [app_core.c, driver_led.c, driver_led.h, main.h, smart-air-hockey-table.ioc]
2023-10-13 Mid-fix of LED drivr
    [app_core.c, driver_led.c, smart-air-hockey-table.ioc]
2023-10-14 Revert changes from previous 3 commits
    [app_core.c, driver_led.c, driver_led.h, main.h, smart-air-hockey-table.ioc]
2023-10-14 Simpler approach to LED driver DMA, complete but untested
2023-10-15 Functioning LED driver
2023-10-15 Correct for snaking pattern when calculating pixel index
    [app_core.c, app_core.h, driver_led.c]
2023-10-16 Fix display driver SPI
    [app_core.c, driver_display.c]
2023-10-16 Increase SPI baud rate, fix ticks_missed, remove Clear from FontTest
    [app_core.c, driver_display.c, smart-air-hockey-table.ioc]
2023-10-16 Latest IOC to firmware-pcb
2023-10-16 Consistent interrupt handler names
2023-10-16 Encoder driver with test code, lower SPI baud rate for stability
    [app_core.c, driver_encoder.c, driver_encoder.h, smart-air-hockey-table.ioc]
2023-10-17 More accurate encoder delta
2023-10-18 Fix wacky delta calculation
    [driver_encoder.c]
2023-10-18 LED driver fix
2023-10-18 Add JLCPCB assembly files
    [Sensor PCB.kicad_pcb, Sensor PCB.kicad_sch]
2023-10-18 I forgor one LED part number
    [Sensor PCB.kicad_sch]
2023-10-18 Add .csv files
    [bom.csv, designators.csv, positions.csv]
2023-10-18 Update D1 part number
    [Sensor PCB.kicad_pcb, bom.csv, designators.csv, positions.csv]
2023-10-18 Update drill and grid origin
    [Sensor PCB.kicad_pcb, bom.csv, designators.csv, positions.csv]
2023-10-18 Implement display power control
2023-10-18 Created driver files
2023-10-18 Implement Goal Detection Driver
    Goal detection uses external interrupts to mark if a player scores by setting the correct value in a ScoreState enum.
    This enum can be checked while the game is running to see if a player scored and can switch states accordingly.
    Since goal detection does not switch states, there is no issue with multiple external interrupts on the same goal being raised.
2023-10-19 Init as error state
    [app_statemachine.c]
2023-10-19 Switch from playerIdx to PlayerId
2023-10-19 Added init function
    Also fixed some errors
    [app_statemachine.c]
2023-10-19 Add hall effect driver
2023-10-19 Add relay driver
2023-10-19 Reference new drivers and add some logic
2023-10-19 Fix case-switch indentation
2023-10-19 Relay output pin
2023-10-19 Commented out relay test lines for future testing
2023-10-19 Fix a couple more while I'm at it
    [app_statemachine.h]
2023-10-20 Functioning quad-channel LED implementation
2023-10-20 Reworked goal detection driver
    Renamed from driver_goaldetection to driver_goal
    Switched from an interrupt-based system, to a poll-based system
    Regenerated code to switch LDRxIN pins from "GPIO_EXTIx" to "GPIO_Input"
    Note: Defines for the GPIO port and pin associated with LDRxIN are based on the nucleo's pinout and will need to be modified for the master PCB
    [driver_goal.c, driver_goal.h, main.h, smart-air-hockey-table.ioc]
2023-10-20 Removed needless prototype name
    Thanks Will <3
2023-10-20 A couple more comments
2023-10-20 Move bitmask checking to driver
2023-10-23 dma_buffer -> led_data
2023-10-24 Fixed
    with team :)
    [driver_goal.c]
2023-10-25 Interleave LED channels, enable timer DMA burst
2023-10-26 Prefer fast inttypes, prefer non-volatile, fix a couple braces
    [app_core.c, app_core.h, app_statemachine.c, app_statemachine.h, driver_display.c, driver_display.h, driver_encoder.c, driver_encoder.h]
2023-10-30 Minor optimizations and refactors
    Did not touch driver_halleffect cuz its kinda nasty and I don't have
    tuples in this language :(
2023-10-31 Revamped firmware-pcb project for U575
2023-11-03 fix typos and removed test code
    [app_core.c]
2023-11-03 Fix row column confusion
    [driver_led.c, driver_led.h]
2023-11-03 Revert "Test code for safekeeping"
    This reverts commit 87239b2765b6424abf970b9c8fb956e4b0ff31ae.
    [app_core.c]
2023-11-03 Revert LED matrix interleaving
    [driver_led.c, driver_led.h, smart-air-hockey-table.ioc]
2023-11-04 Add spacer CAD files
    [Spacers.FCStd]
2023-11-04 Add mention of acrylic spacers
2023-11-04 Add CAD model image
2023-11-05 Add launch configurations, more GPDMA channels for LED driver
2023-11-06 Change LED resistor values
    [Buck Converter.kicad_sch, Master PCB.kicad_sch, STM32.kicad_sch]
2023-11-07 Fix a few hall effect pins, reverse direction of encoder button
    [driver_halleffect.c, smart-air-hockey-table.ioc]
2023-11-07 Reverse encoder button in PCB project
    [smart-air-hockey-table.ioc]
2023-11-07 Baud rate to 10 Mbit, bring in halleffect fixes, implement LED matrix test
    [app_core.c, driver_halleffect.c, driver_led.c, driver_led.h, smart-air-hockey-table.ioc]
2023-11-07 Revert app_core.c to match nucleo for merging into main
    [app_core.c]
2023-11-07 Remove symbolic link entirely
    [Buck Converter.kicad_sch, Built+to+size.f3d, Built+to+size.stl, EEPROM.kicad_sch, Goal Detector.kicad_sch, LED.kicad_sch, Master PCB.kicad_pcb, Master PCB.kicad_sch]
2023-11-07 Alan :nerd:
    [Buck Converter.kicad_sch, Built+to+size.f3d, Built+to+size.stl, EEPROM.kicad_sch, Goal Detector.kicad_sch, LED.kicad_sch, Master PCB.kicad_pcb, Master PCB.kicad_sch]
2023-11-10 Add 65mm puck
    [Puck-Body-65mm.stl, Puck-Body-75mm.stl, Puck.FCStd]
2023-11-14 Move to firmware-pcb, remove autogen comment block
2023-11-14 Move changes to firmware-pcb
2023-11-18 Increase height to 0.5 inches
    [Spacers-Body.stl, Spacers.FCStd]
2023-11-27 Tickrate to 250 Hz
2023-11-29 Update spacers to final version
    [Spacers-Body.stl, Spacers.FCStd]
2023-12-01 Rainbow flow in idle state
2023-12-01 Add eeprom driver
    Blood, sweat, and tears
2023-12-01 Correct goal detection logic
    [app_core.c, app_statemachine.c, driver_goal.c]
2023-12-01 Fix side-effect from merge
    [driver_led.c]
2023-12-03 Add final puck files
    [Puck-Body-65mm.stl, Puck-Body-75mm.stl, Puck-SingleMagnet-Body.stl, Puck-SingleMagnet.FCStd, Puck.FCStd]
2023-12-03 Re-add spacers lol
    [Spacers-Body.stl, Spacers.FCStd]
2023-12-07 Add header to score display, prints on start state
2023-12-07 Reduce clear LED calls and LED tick calls
2023-12-07 Fix 'Game Score' OLED display
    [app_statemachine.c]
2023-12-07 Remove unneeded Driver_Display_Clear
2023-12-07 Revert "Removed unused"
    This reverts commit c0db7cf6a4637f448fdac7ba7140cfa68eb23a19.
    [driver_led.c]
2023-12-07 clear trail on switch
2023-12-08 Encoder button fix
2023-12-08 Larger magnet
    [Puck-SingleMagnet-Body-Medium.stl, Puck-SingleMagnet.FCStd]
2023-12-09 Restore softlink to hardware folder, add 5 more CAD models, fix documents page
    [Goal_Chute.f3d, Goal_Chute.stl, Knob.f3d, Knob.stl, PCB_Mounting.f3d, PCB_Mounting.stl, PSU_Mounting.f3d, PSU_Mounting.stl]
