alanssitis/smart-air-hockey-table/web/public/team/ben/week14-pcbs.jpg

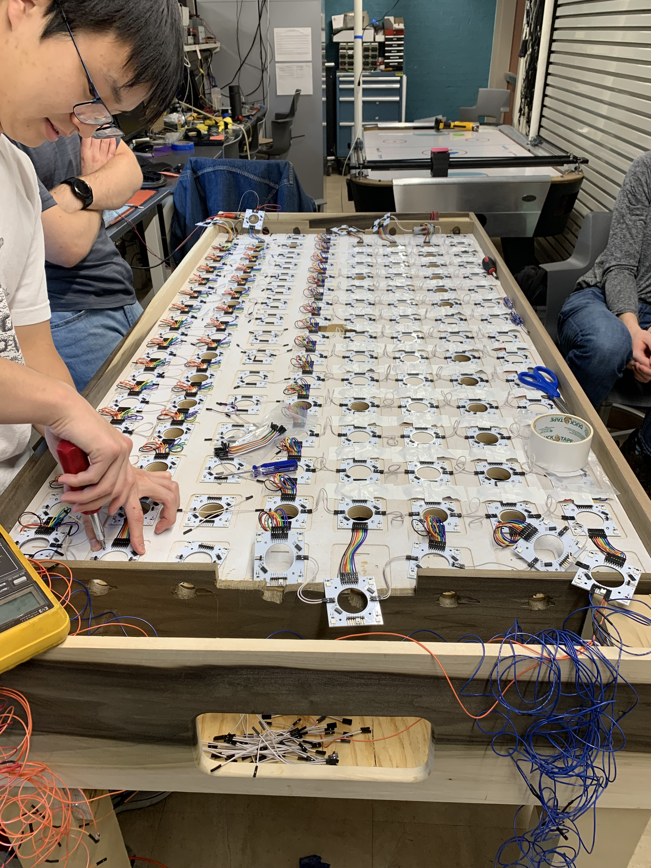
[picture p14: web/public/team/ben/week14-pcbs.jpg]
web/public/team/ben/week14-pcbs.jpg
