alanssitis/smart-air-hockey-table/web/public/team/ben/week14-pcb-testing.jpg

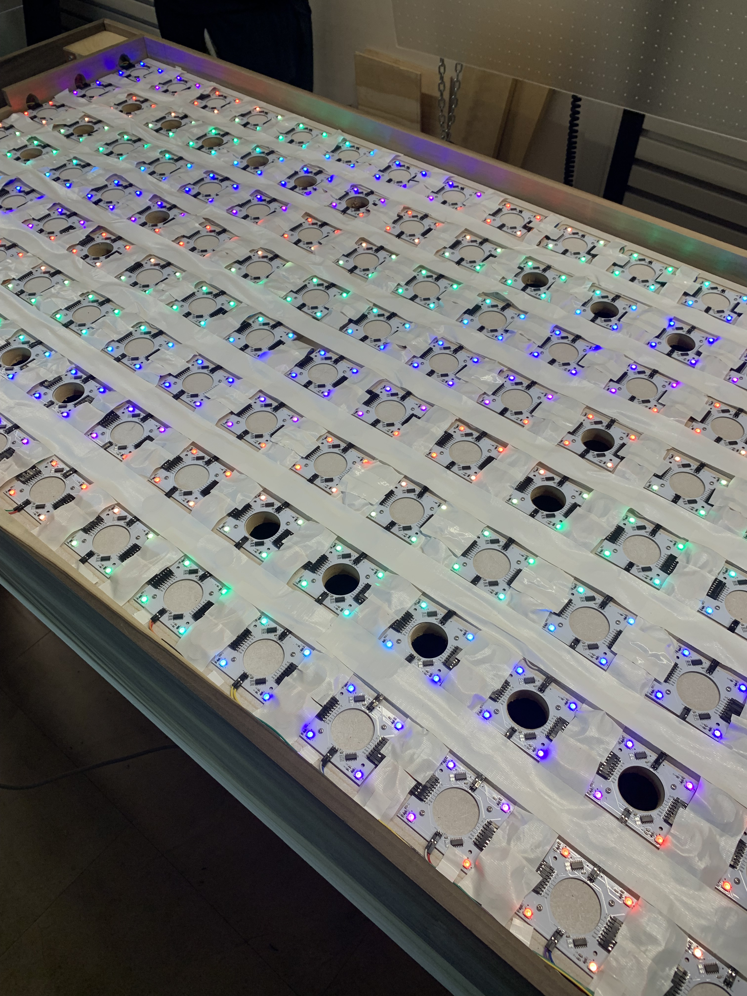
[picture p16: web/public/team/ben/week14-pcb-testing.jpg]
web/public/team/ben/week14-pcb-testing.jpg
